Gonzalogontad/ProyectoFinalCESEGG/Hard/ModAdicionales/Mod_Temp_Driver/Mod_Temp_Driver.kicad_pcb

## KiCad design Hard/ModAdicionales/Mod_Temp_Driver/Mod_Temp_Driver.kicad_pcb (2020-06-04)

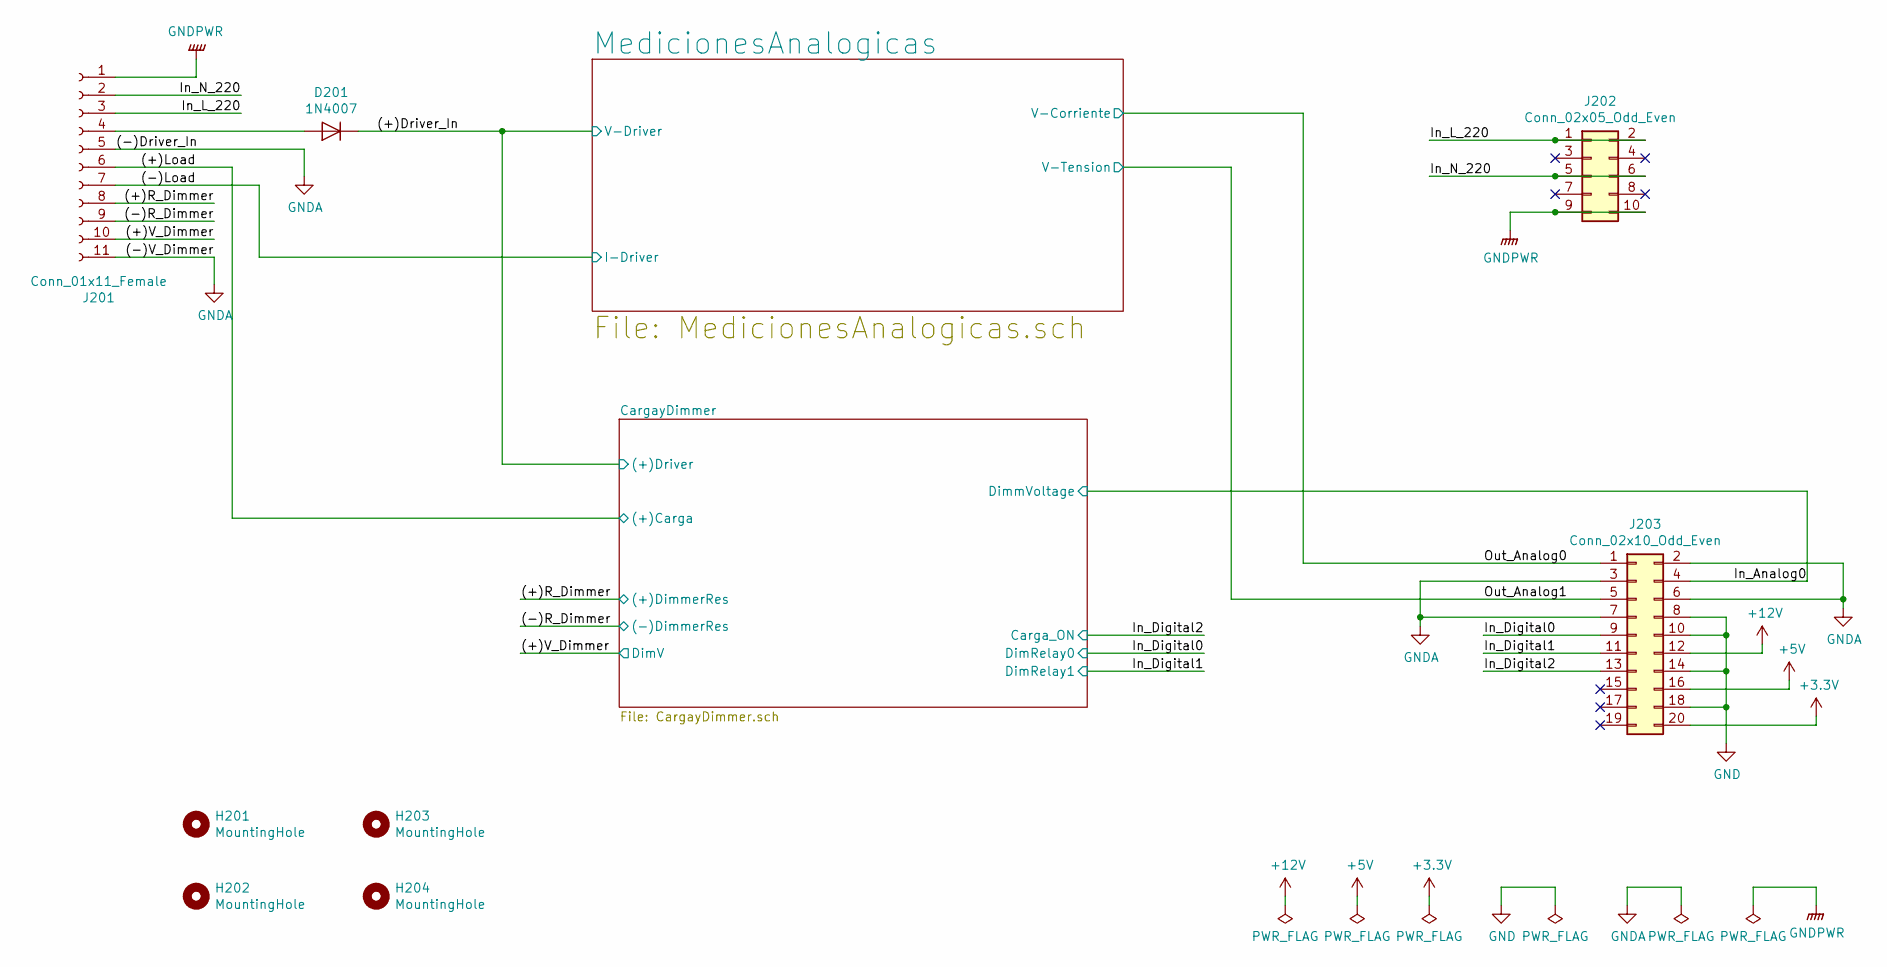
[picture p1: schematic ProbadorDriver.sch, Proyecto Final - Modulos Adicionales]

Parts:
D201: 1N4007; D_DO-41_SOD81_P10.16mm_Horizontal
H201, H202, H203, H204: MountingHole; MountingHole_3.2mm_M3
J201: Conn_01x11_Female; TerminalBlock_bornier-11_P5.00mm
J202: Conn_02x05_Odd_Even; PinHeader_2x05_P2.54mm_Horizontal
J203: Conn_02x10_Odd_Even; PinHeader_2x10_P2.54mm_Horizontal

Connections:
+3V3: J203.20
+5V: J203.16
+12V: J203.12; also elsewhere on the board
/ProbadorDriver/(+)Driver_In: D201.1 (K); also elsewhere on the board
/ProbadorDriver/(+)Load: J201.6; also elsewhere on the board
/ProbadorDriver/(+)R_Dimmer: J201.8; also elsewhere on the board
/ProbadorDriver/(+)V_Dimmer: J201.10; also elsewhere on the board
/ProbadorDriver/(-)Load: J201.7; also elsewhere on the board
/ProbadorDriver/(-)R_Dimmer: J201.9; also elsewhere on the board
/ProbadorDriver/In_Analog0: J203.4; also elsewhere on the board
/ProbadorDriver/In_Digital0: J203.9; also elsewhere on the board
/ProbadorDriver/In_Digital1: J203.11; also elsewhere on the board
/ProbadorDriver/In_Digital2: J203.13; also elsewhere on the board
/ProbadorDriver/In_L_220: J201.3, J202.1, J202.2
/ProbadorDriver/In_N_220: J201.2, J202.5, J202.6
/ProbadorDriver/Out_Analog0: J203.1; also elsewhere on the board
/ProbadorDriver/Out_Analog1: J203.5; also elsewhere on the board
GND: J203.8, J203.10, J203.14, J203.18; also elsewhere on the board
GNDA: J201.5, J201.11, J203.2, J203.3, J203.6, J203.7; also elsewhere on the board
GNDPWR: J201.1, J202.9, J202.10
unnamed: D201.2 (A), J201.4

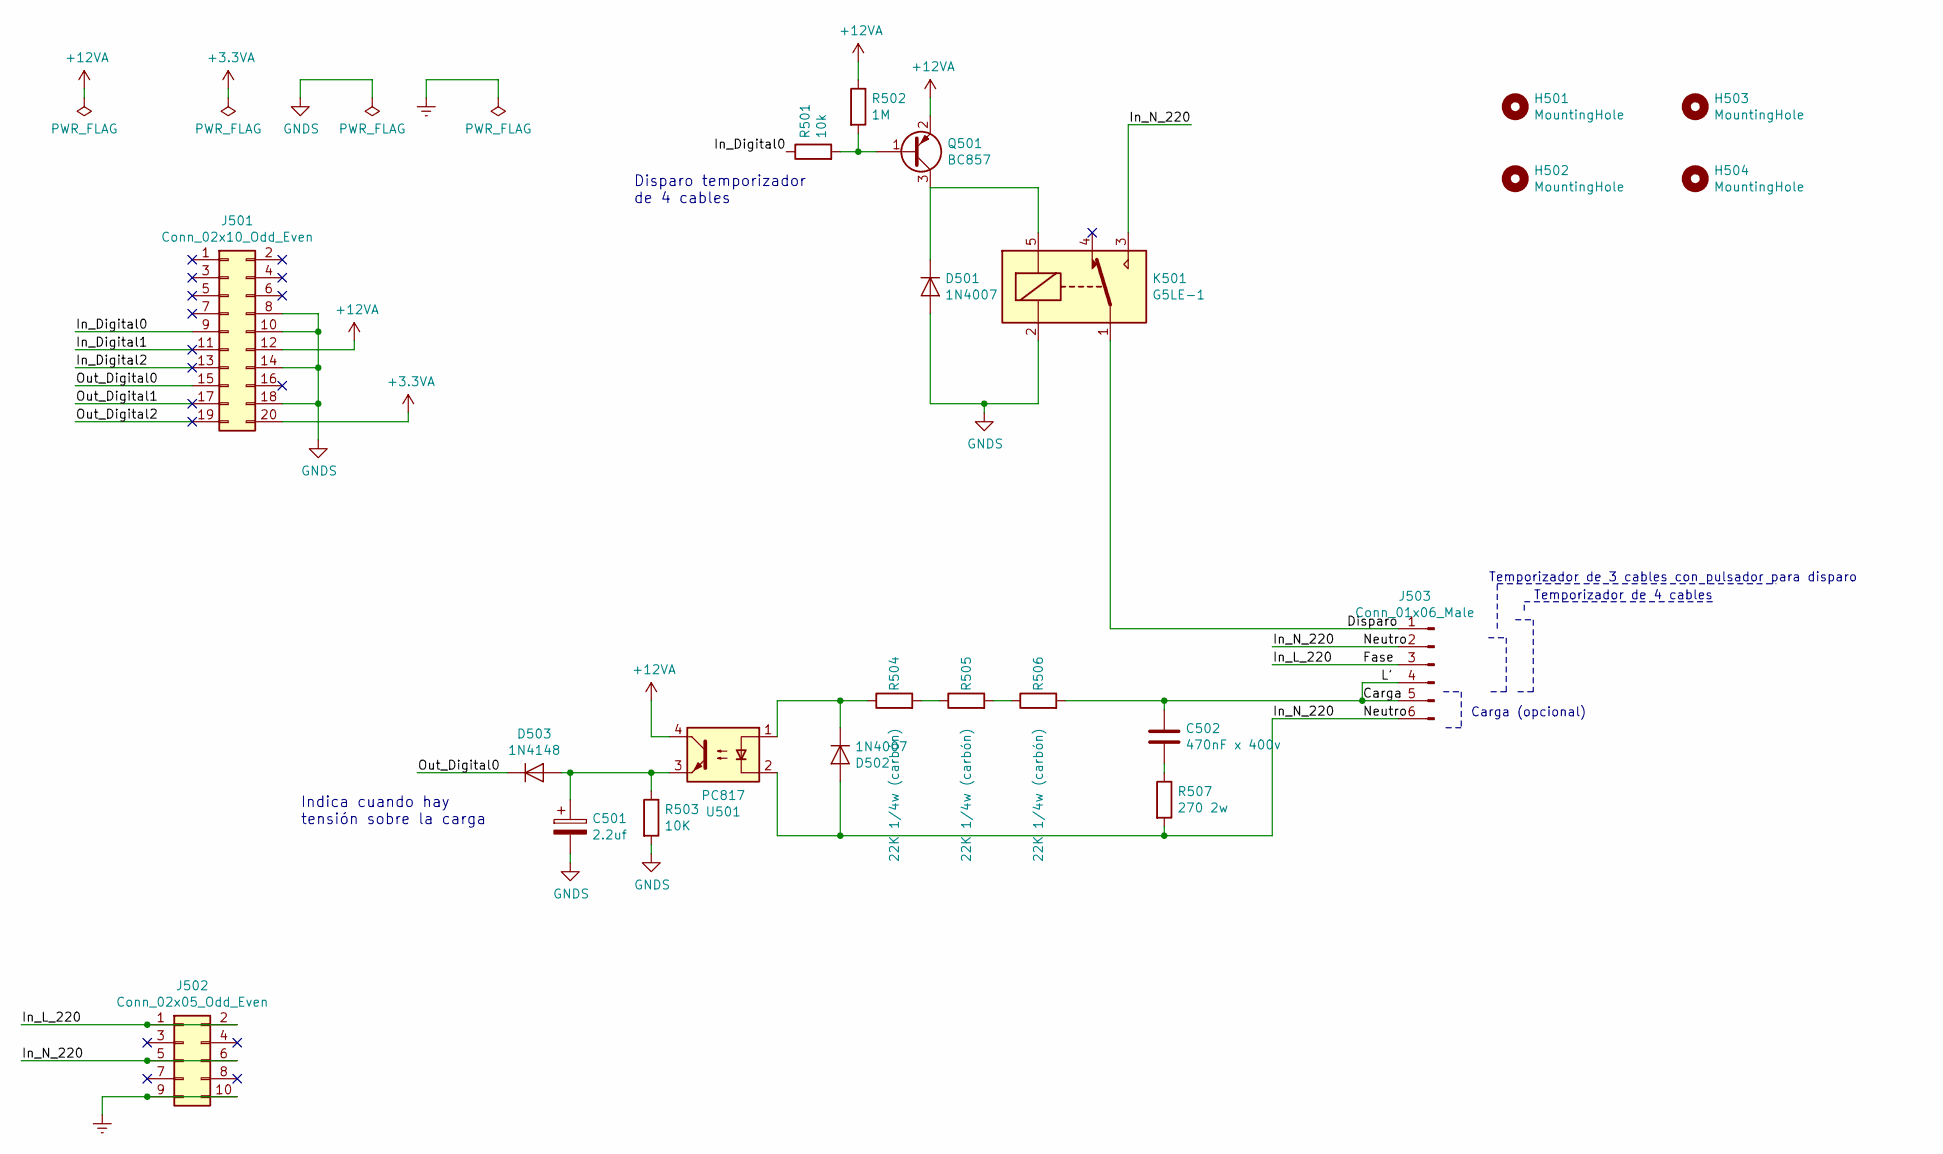
[picture p2: schematic ProbadorTemporizador.sch, Proyecto Final - Modulos Adicionales]

Parts:
C501: 2.2uf; CP_Radial_D5.0mm_P2.00mm
C502: 470nF x 400v; C_Rect_L16.5mm_W8.7mm_P15.00mm_MKT
D501, D502: 1N4007; D_DO-41_SOD81_P10.16mm_Horizontal
D503: 1N4148; D_MiniMELF
H501, H502, H503, H504: MountingHole; MountingHole_3.2mm_M3
J501: Conn_02x10_Odd_Even; PinHeader_2x10_P2.54mm_Horizontal
J502: Conn_02x05_Odd_Even; PinHeader_2x05_P2.54mm_Horizontal
J503: Conn_01x06_Male; TerminalBlock_bornier-6_P5.00mm
K501: G5LE-1; Relay_SPDT_Omron-G5LE-1
Q501: BC857; SOT-23
R501: 10k; R_0805_2012Metric_Pad1.15x1.40mm_HandSolder
R502: 1M; R_0805_2012Metric_Pad1.15x1.40mm_HandSolder
R503: 10K; R_0805_2012Metric_Pad1.15x1.40mm_HandSolder
R504, R505, R506: 22K 1/4w (carbón); R_Axial_DIN0207_L6.3mm_D2.5mm_P7.62mm_Horizontal
R507: 270 2w; R_Axial_DIN0516_L15.5mm_D5.0mm_P20.32mm_Horizontal
U501: PC817; DIP-4_W7.62mm

Connections:
+3.3VA: J501.20
+12VA: J501.12, Q501.2 (E), R502.1, U501.4
/ProbadorTemporizador/Carga: C502.1, J503.4, J503.5, R506.2
/ProbadorTemporizador/Disparo: J503.1, K501.1
/ProbadorTemporizador/Fase: J502.1, J502.2, J503.3
/ProbadorTemporizador/In_Digital0: J501.9, R501.1
/ProbadorTemporizador/In_Digital1: J501.11
/ProbadorTemporizador/In_Digital2: J501.13
/ProbadorTemporizador/In_N_220: D502.2 (A), J502.5, J502.6, J503.2, J503.6, K501.3, R507.2, U501.2
/ProbadorTemporizador/Out_Digital0: D503.1 (K), J501.15
/ProbadorTemporizador/Out_Digital1: J501.17
/ProbadorTemporizador/Out_Digital2: J501.19
Earth: J502.9, J502.10
GNDS: C501.2, D501.2 (A), J501.8, J501.10, J501.14, J501.18, K501.2, R503.2
unnamed: C501.1, D503.2 (A), R503.1, U501.3
unnamed: C502.2, R507.1
unnamed: D501.1 (K), K501.5, Q501.3 (C)
unnamed: D502.1 (K), R504.1, U501.1
unnamed: Q501.1 (B), R501.2, R502.2
unnamed: R504.2, R505.1
unnamed: R505.2, R506.1

Notes on the sheet:
Carga (opcional)
Temporizador de 3 cables con pulsador para disparo
Temporizador de 4 cables
Disparo temporizador de 4 cables
Indica cuando hay tensión sobre la carga

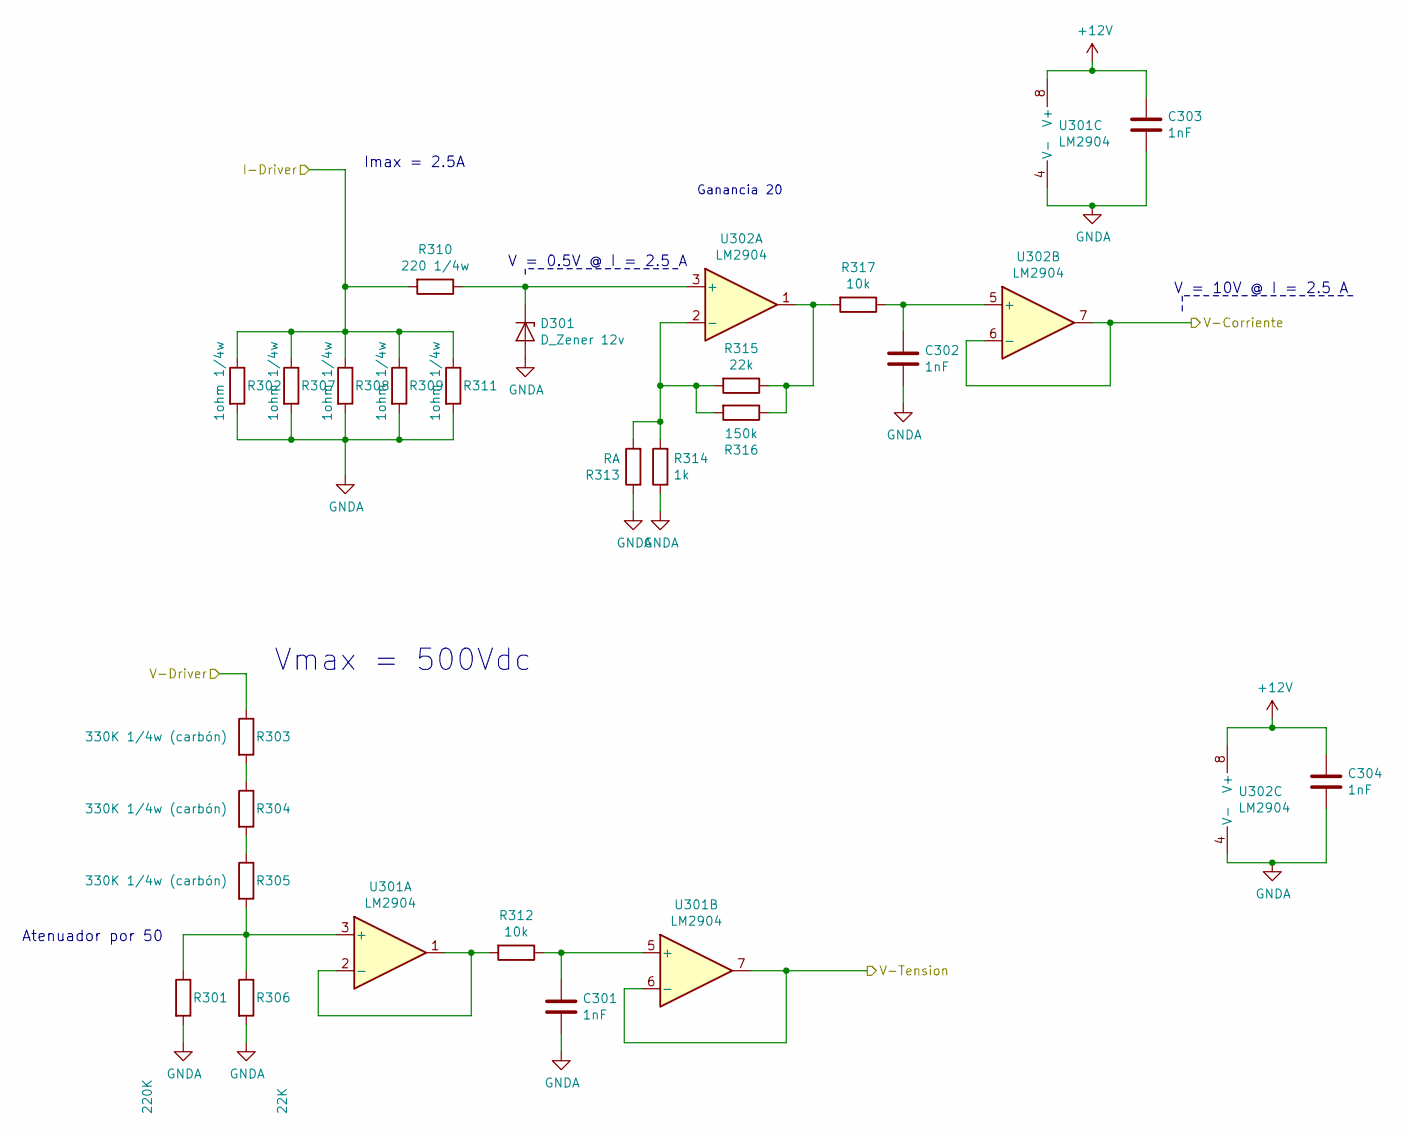
[picture p3: schematic MedicionesAnalogicas.sch, Proyecto Final - Modulos Adicionales]

Parts:
C301, C302, C303, C304: 1nF; C_0805_2012Metric_Pad1.15x1.40mm_HandSolder
D301: D_Zener 12v; D_DO-35_SOD27_P7.62mm_Horizontal
R301: 220K; R_0805_2012Metric_Pad1.15x1.40mm_HandSolder
R302, R307, R308, R309, R311: 1ohm 1/4w; R_Axial_DIN0207_L6.3mm_D2.5mm_P7.62mm_Horizontal
R303, R304, R305: 330K 1/4w (carbón); R_Axial_DIN0207_L6.3mm_D2.5mm_P7.62mm_Horizontal
R306: 22K; R_0805_2012Metric_Pad1.15x1.40mm_HandSolder
R310: 220 1/4w; R_Axial_DIN0207_L6.3mm_D2.5mm_P7.62mm_Horizontal
R312, R317: 10k; R_0805_2012Metric_Pad1.15x1.40mm_HandSolder
R313: RA; R_0805_2012Metric_Pad1.15x1.40mm_HandSolder
R314: 1k; R_0805_2012Metric_Pad1.15x1.40mm_HandSolder
R315: 22k; R_0805_2012Metric_Pad1.15x1.40mm_HandSolder
R316: 150k; R_0805_2012Metric_Pad1.15x1.40mm_HandSolder
U301, U302: LM2904; SO-8_3.9x4.9mm_P1.27mm

Connections:
+12V: C303.1, C304.1, U301.8 (V+), U302.8 (V+); also elsewhere on the board
/ProbadorDriver/(+)Driver_In: R303.1; also elsewhere on the board
/ProbadorDriver/(-)Load: R302.1, R307.1, R308.1, R309.1, R310.2, R311.1; also elsewhere on the board
/ProbadorDriver/Out_Analog0: U302.6 (-), U302.7; also elsewhere on the board
/ProbadorDriver/Out_Analog1: U301.6 (-), U301.7; also elsewhere on the board
GNDA: C301.2, C302.2, C303.2, C304.2, D301.2 (A), R301.2, R302.2, R306.2, R307.2, R308.2, R309.2, R311.2, R313.1, R314.1, U301.4 (V-), U302.4 (V-); also elsewhere on the board
unnamed: C301.1, R312.1, U301.5 (+)
unnamed: C302.1, R317.1, U302.5 (+)
unnamed: D301.1 (K), R310.1, U302.3 (+)
unnamed: R301.1, R305.2, R306.1, U301.3 (+)
unnamed: R303.2, R304.1
unnamed: R304.2, R305.1
unnamed: R312.2, U301.1, U301.2 (-)
unnamed: R313.2, R314.2, R315.2, R316.2, U302.2 (-)
unnamed: R315.1, R316.1, R317.2, U302.1

Notes on the sheet:
Ganancia 20
Vmax = 500Vdc
Atenuador por 50
Imax = 2.5A
V = 0.5V @ I = 2.5 A
V = 10V @ I = 2.5 A

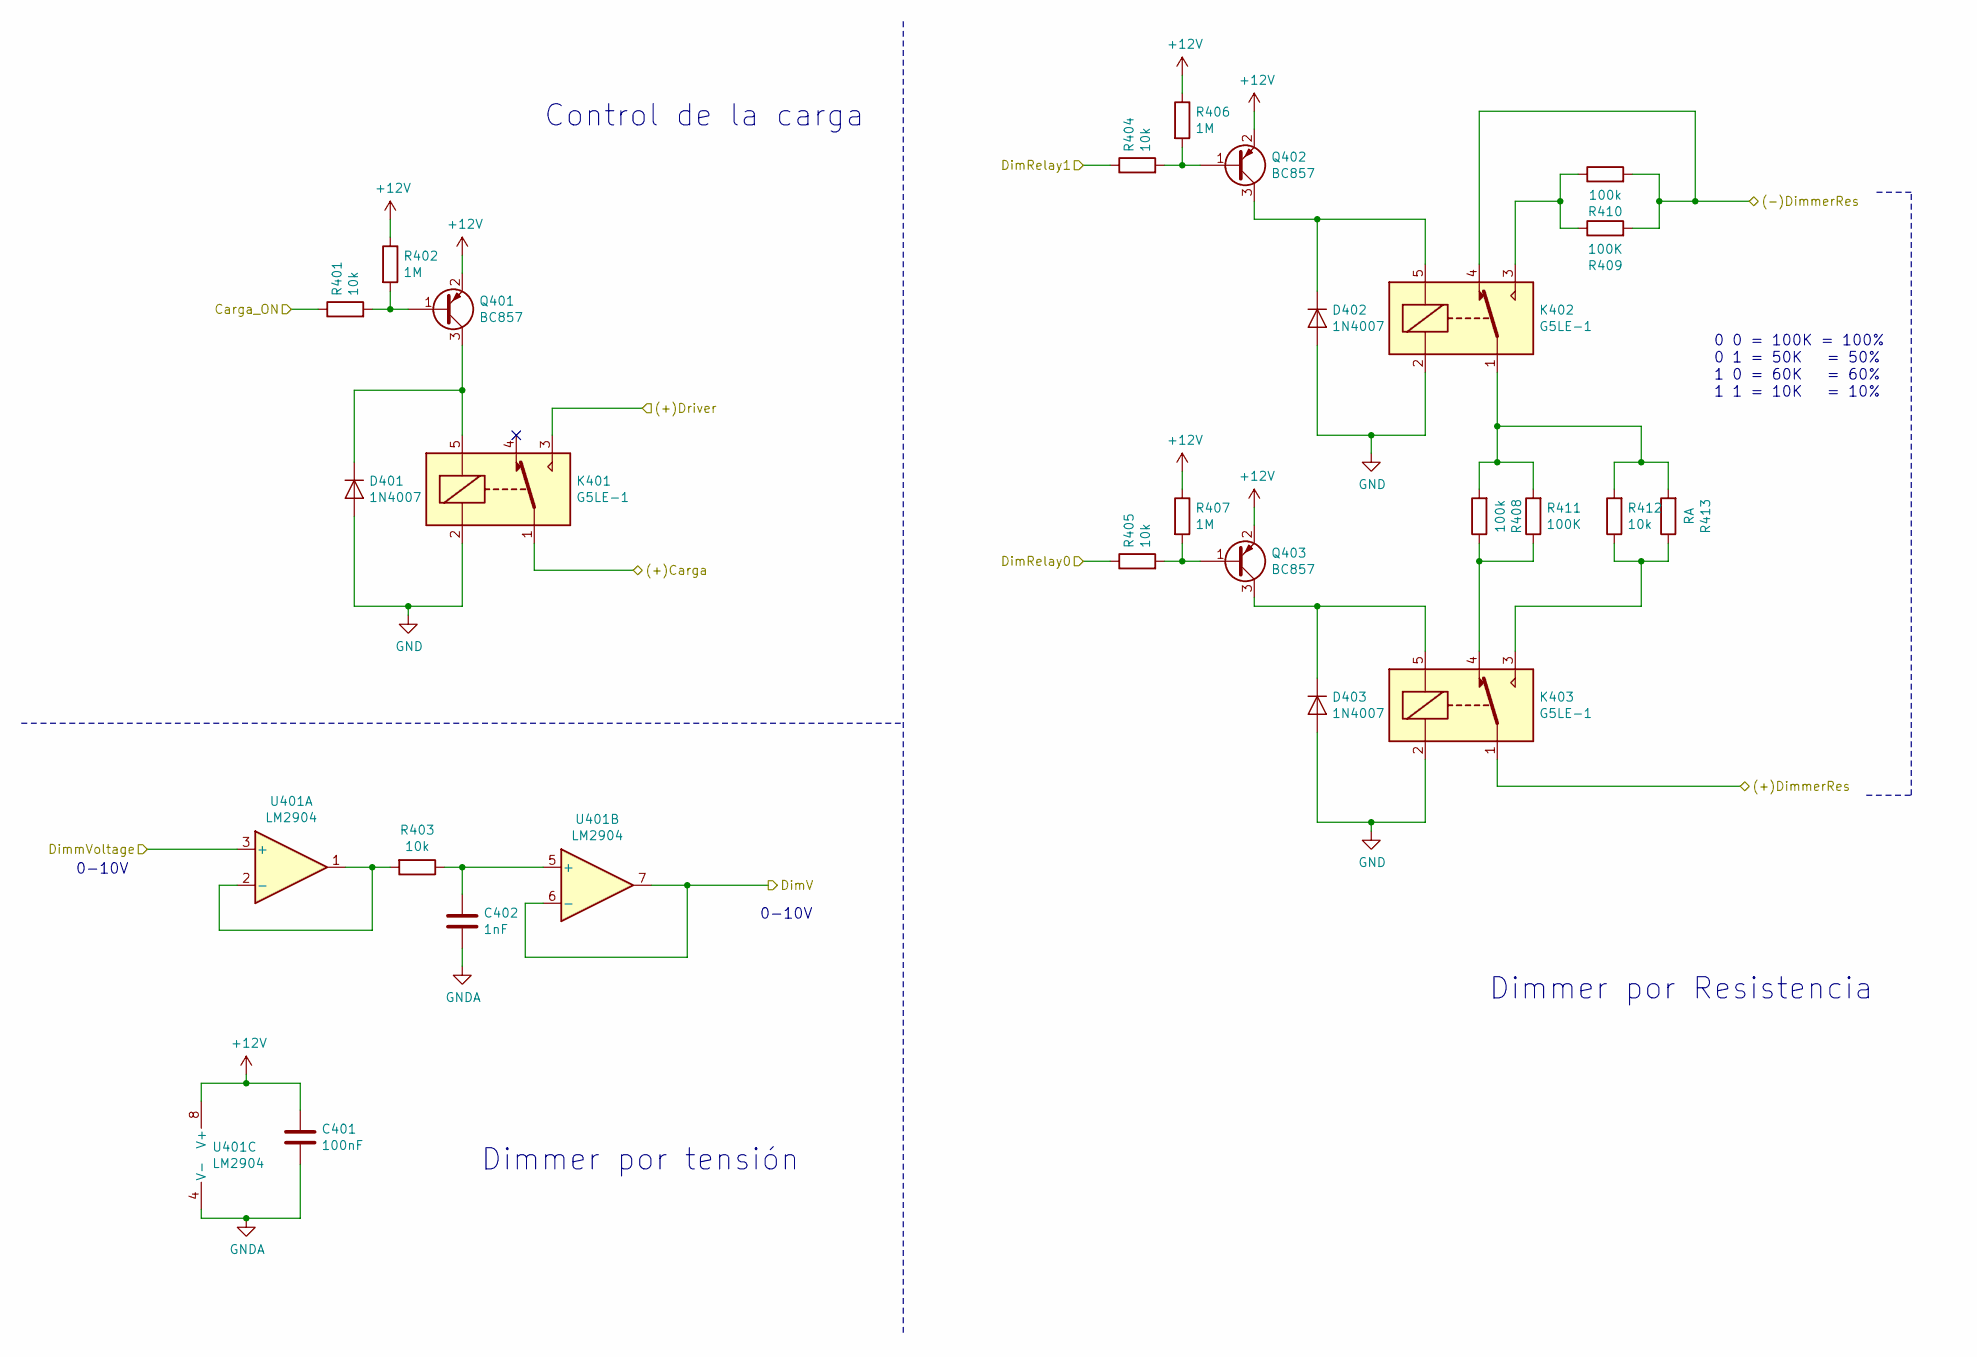
[picture p4: schematic CargayDimmer.sch, Proyecto Final - Modulos Adicionales]

Parts:
C401: 100nF; C_0805_2012Metric_Pad1.15x1.40mm_HandSolder
C402: 1nF; C_0805_2012Metric_Pad1.15x1.40mm_HandSolder
D401, D402, D403: 1N4007; D_DO-41_SOD81_P10.16mm_Horizontal
K401, K402, K403: G5LE-1; Relay_SPDT_Omron-G5LE-1
Q401, Q402, Q403: BC857; SOT-23
R401, R403, R404, R405, R412: 10k; R_0805_2012Metric_Pad1.15x1.40mm_HandSolder
R402, R406, R407: 1M; R_0805_2012Metric_Pad1.15x1.40mm_HandSolder
R408, R410: 100k; R_0805_2012Metric_Pad1.15x1.40mm_HandSolder
R409, R411: 100K; R_0805_2012Metric_Pad1.15x1.40mm_HandSolder
R413: RA; R_0805_2012Metric_Pad1.15x1.40mm_HandSolder
U401: LM2904; SO-8_3.9x4.9mm_P1.27mm

Connections:
+12V: C401.1, Q401.2 (E), Q402.2 (E), Q403.2 (E), R402.1, R406.1, R407.1, U401.8 (V+); also elsewhere on the board
/ProbadorDriver/(+)Driver_In: K401.3; also elsewhere on the board
/ProbadorDriver/(+)Load: K401.1; also elsewhere on the board
/ProbadorDriver/(+)R_Dimmer: K403.1; also elsewhere on the board
/ProbadorDriver/(+)V_Dimmer: U401.6 (-), U401.7; also elsewhere on the board
/ProbadorDriver/(-)R_Dimmer: K402.4, R409.2, R410.2; also elsewhere on the board
/ProbadorDriver/In_Analog0: U401.3 (+); also elsewhere on the board
/ProbadorDriver/In_Digital0: R405.1; also elsewhere on the board
/ProbadorDriver/In_Digital1: R404.1; also elsewhere on the board
/ProbadorDriver/In_Digital2: R401.1; also elsewhere on the board
GND: D401.2 (A), D402.2 (A), D403.2 (A), K401.2, K402.2, K403.2; also elsewhere on the board
GNDA: C401.2, C402.2, U401.4 (V-); also elsewhere on the board
unnamed: C402.1, R403.1, U401.5 (+)
unnamed: D401.1 (K), K401.5, Q401.3 (C)
unnamed: D402.1 (K), K402.5, Q402.3 (C)
unnamed: D403.1 (K), K403.5, Q403.3 (C)
unnamed: K402.1, R408.2, R411.2, R412.2, R413.2
unnamed: K402.3, R409.1, R410.1
unnamed: K403.3, R412.1, R413.1
unnamed: K403.4, R408.1, R411.1
unnamed: Q401.1 (B), R401.2, R402.2
unnamed: Q402.1 (B), R404.2, R406.2
unnamed: Q403.1 (B), R405.2, R407.2
unnamed: R403.2, U401.1, U401.2 (-)

Notes on the sheet:
Control de la carga
Dimmer por tensión
Dimmer por Resistencia
0-10V
0 0 = 100K = 100% 0 1 = 50K = 50% 1 0 = 60K = 60% 1 1 = 10K = 10%

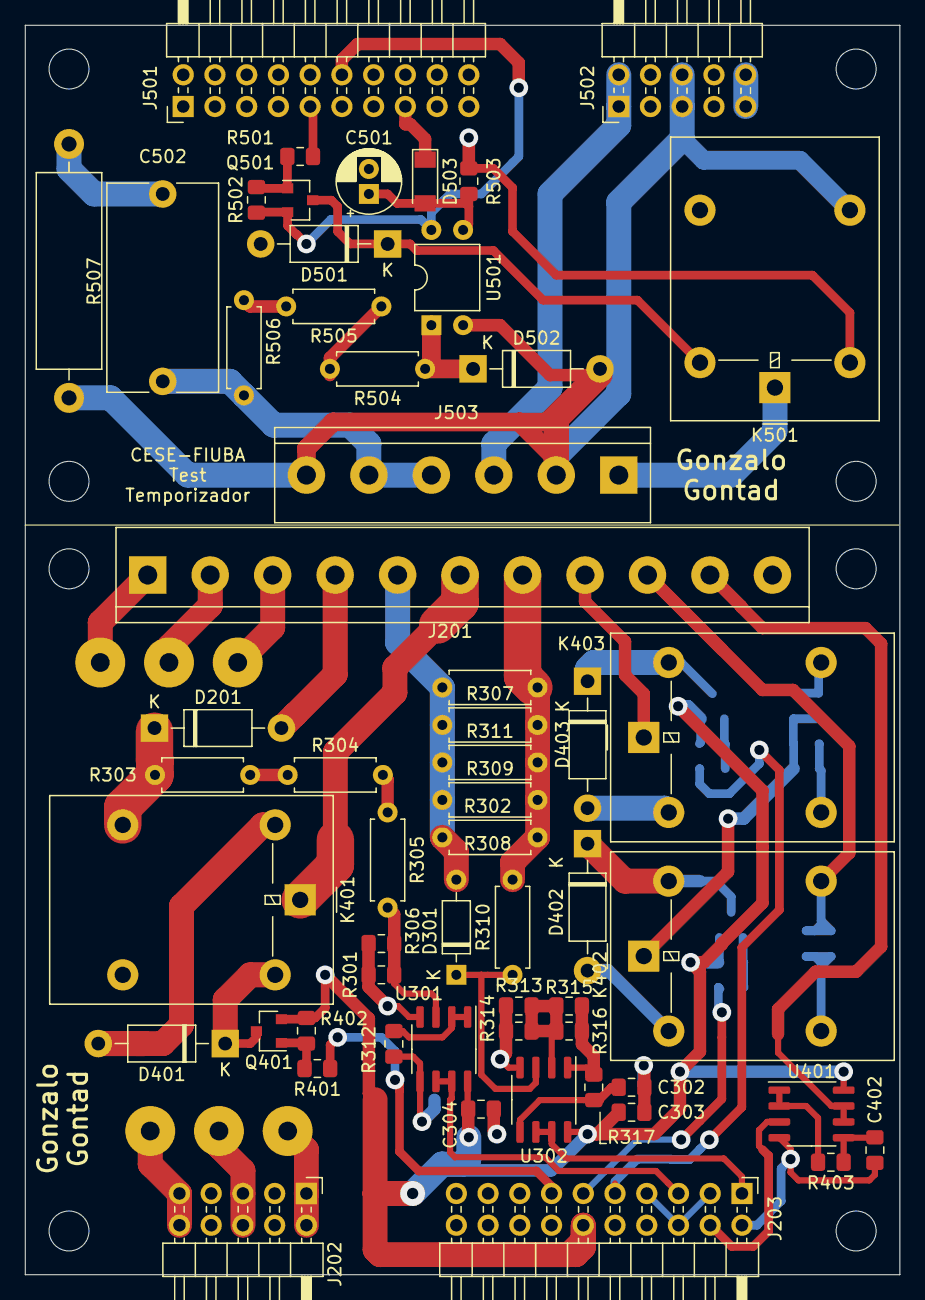
[picture p5: board Mod_Temp_Driver.kicad_pcb from above]

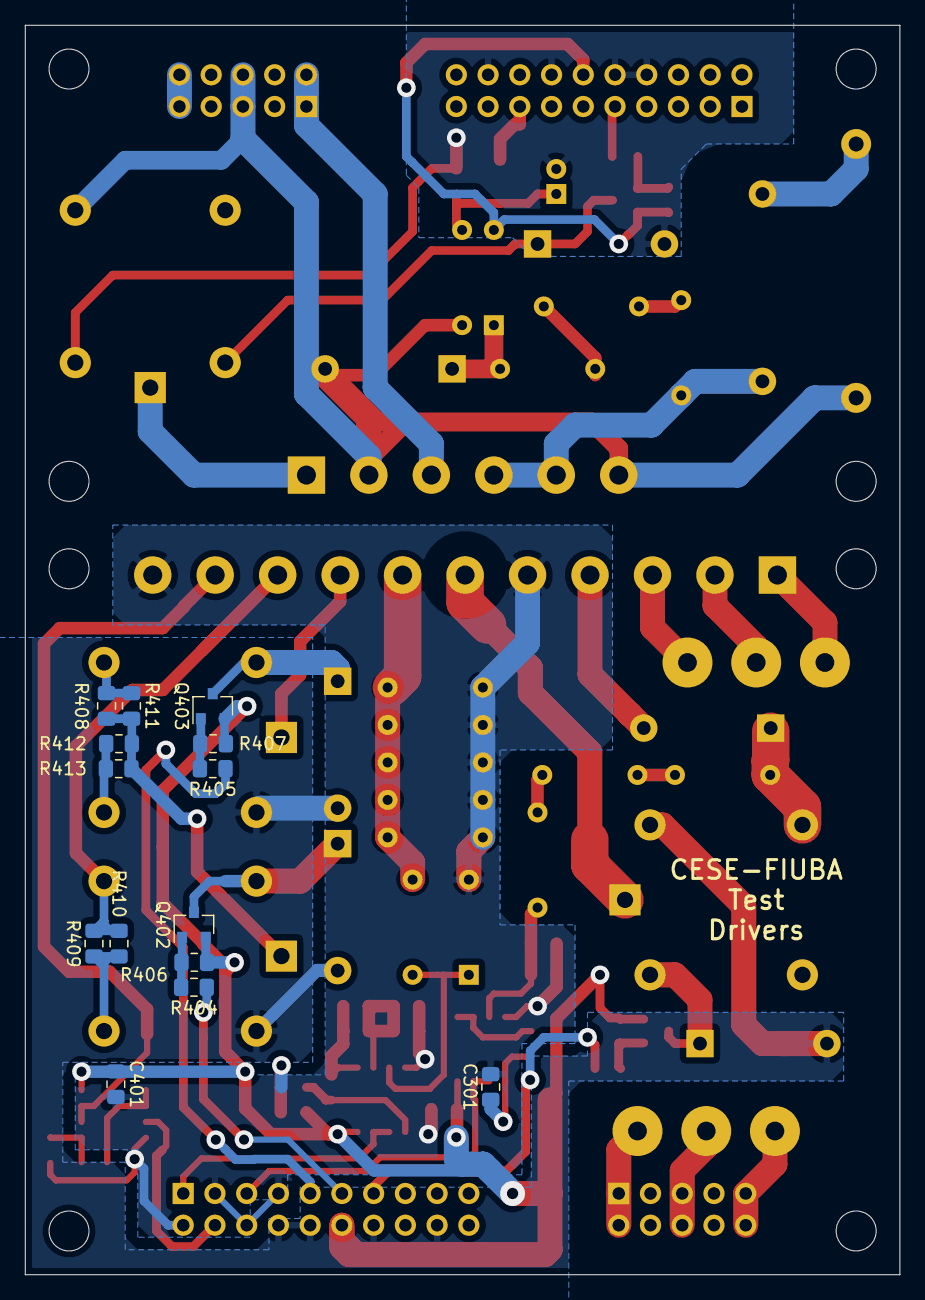
[picture p6: board Mod_Temp_Driver.kicad_pcb from below]

Board: 2 copper layers, 70.0 x 100.0 mm, 79 parts (14 on the bottom side), 56 nets.
