Gonzalogontad/ProyectoFinalCESEGG/Hard/ModPrincipal/ModPrincipal.kicad_pcb

## KiCad design Hard/ModPrincipal/ModPrincipal.kicad_pcb (2020-06-04)

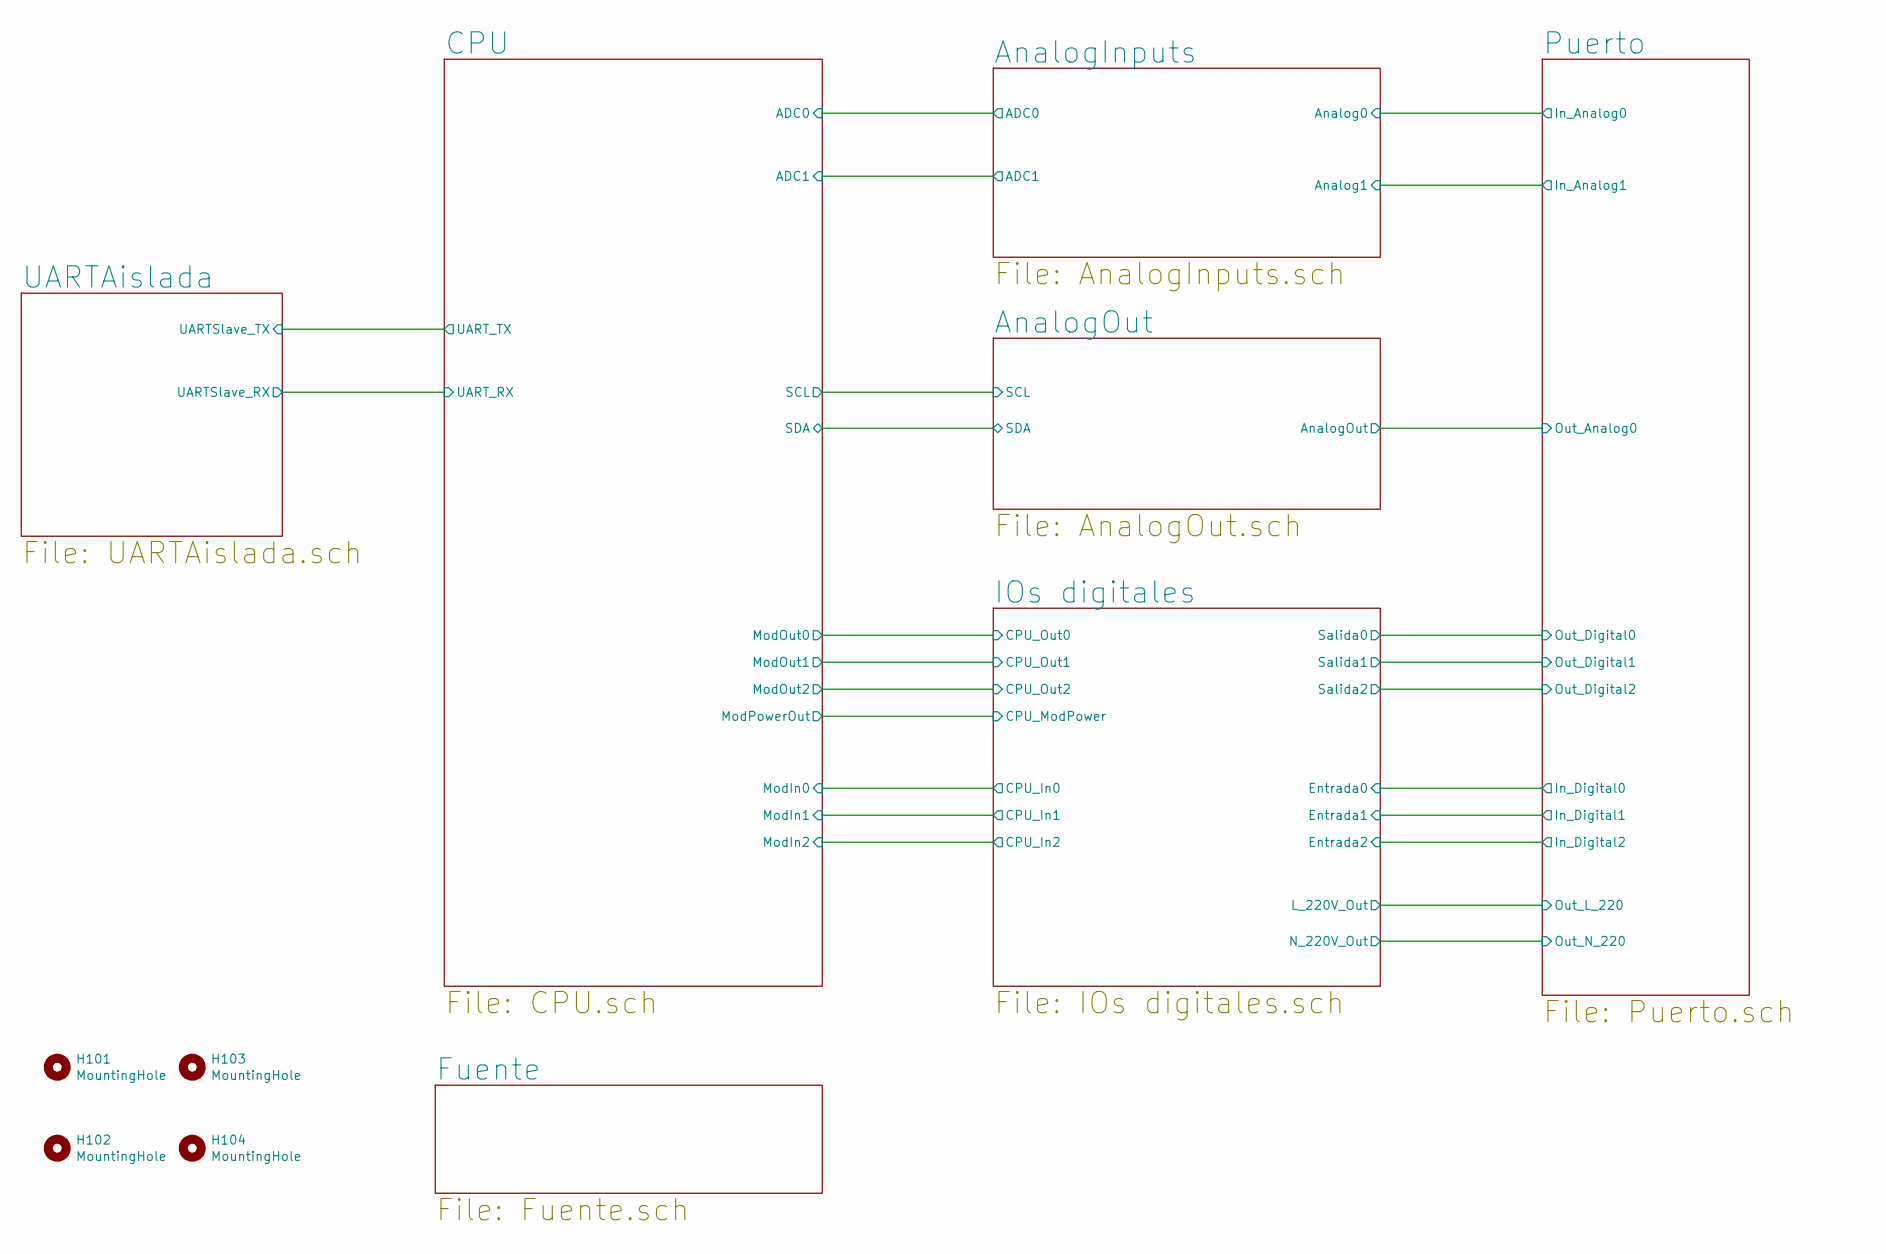
[picture p7: schematic ModPrincipal.sch, Probado - Modulo Principal]

Parts:
H101, H102, H103, H104: MountingHole; MountingHole_3.2mm_M3

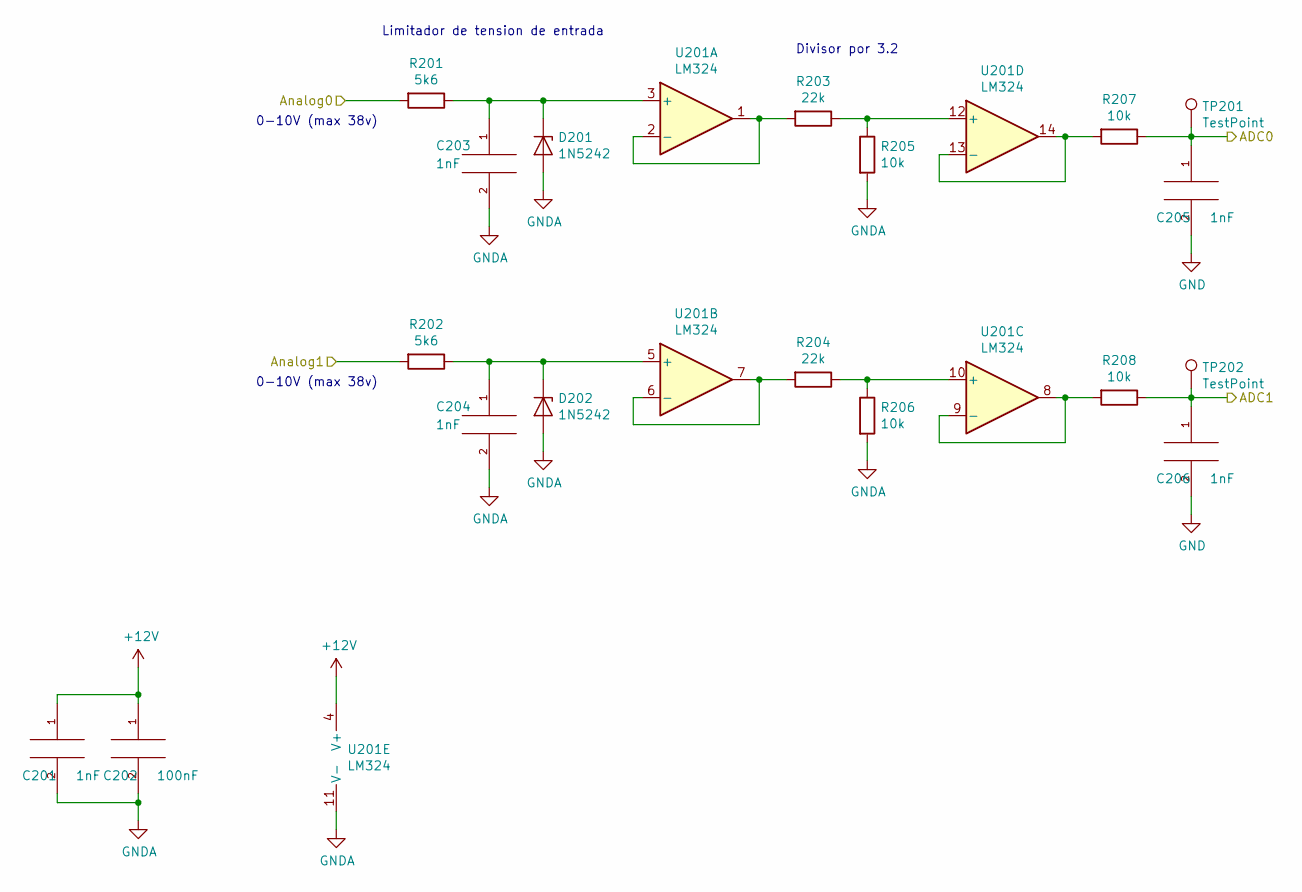
[picture p8: schematic AnalogInputs.sch, Probado - Modulo Principal]

Parts:
C201, C203, C204, C205, C206: 1nF; C_0805_2012Metric_Pad1.15x1.40mm_HandSolder
C202: 100nF; C_0805_2012Metric_Pad1.15x1.40mm_HandSolder
D201, D202: 1N5242; D_DO-35_SOD27_P7.62mm_Horizontal
R201, R202: 5k6; R_0805_2012Metric_Pad1.15x1.40mm_HandSolder
R203, R204: 22k; R_0805_2012Metric_Pad1.15x1.40mm_HandSolder
R205, R206, R207, R208: 10k; R_0805_2012Metric_Pad1.15x1.40mm_HandSolder
TP201, TP202: TestPoint; TestPoint_Pad_D1.5mm
U201: LM324; SOIC-14_3.9x8.7mm_P1.27mm

Connections:
+12V: C201.1, C202.1, U201.4 (V+); also elsewhere on the board
/AnalogInputs/ADC0: C205.1, R207.1, TP201.1; also elsewhere on the board
/AnalogInputs/ADC1: C206.1, R208.1, TP202.1; also elsewhere on the board
/AnalogInputs/Analog0: R201.2; also elsewhere on the board
/AnalogInputs/Analog1: R202.2; also elsewhere on the board
GND: C205.2, C206.2; also elsewhere on the board
GNDA: C201.2, C202.2, C203.2, C204.2, D201.2 (A), D202.2 (A), R205.2, R206.2, U201.11 (V-); also elsewhere on the board
unnamed: C203.1, D201.1 (K), R201.1, U201.3 (+)
unnamed: C204.1, D202.1 (K), R202.1, U201.5 (+)
unnamed: R203.1, R205.1, U201.12 (+)
unnamed: R203.2, U201.1, U201.2 (-)
unnamed: R204.1, R206.1, U201.10 (+)
unnamed: R204.2, U201.6 (-), U201.7
unnamed: R207.2, U201.13 (-), U201.14
unnamed: R208.2, U201.8, U201.9 (-)

Notes on the sheet:
0-10V (max 38v)
Divisor por 3.2
Limitador de tension de entrada

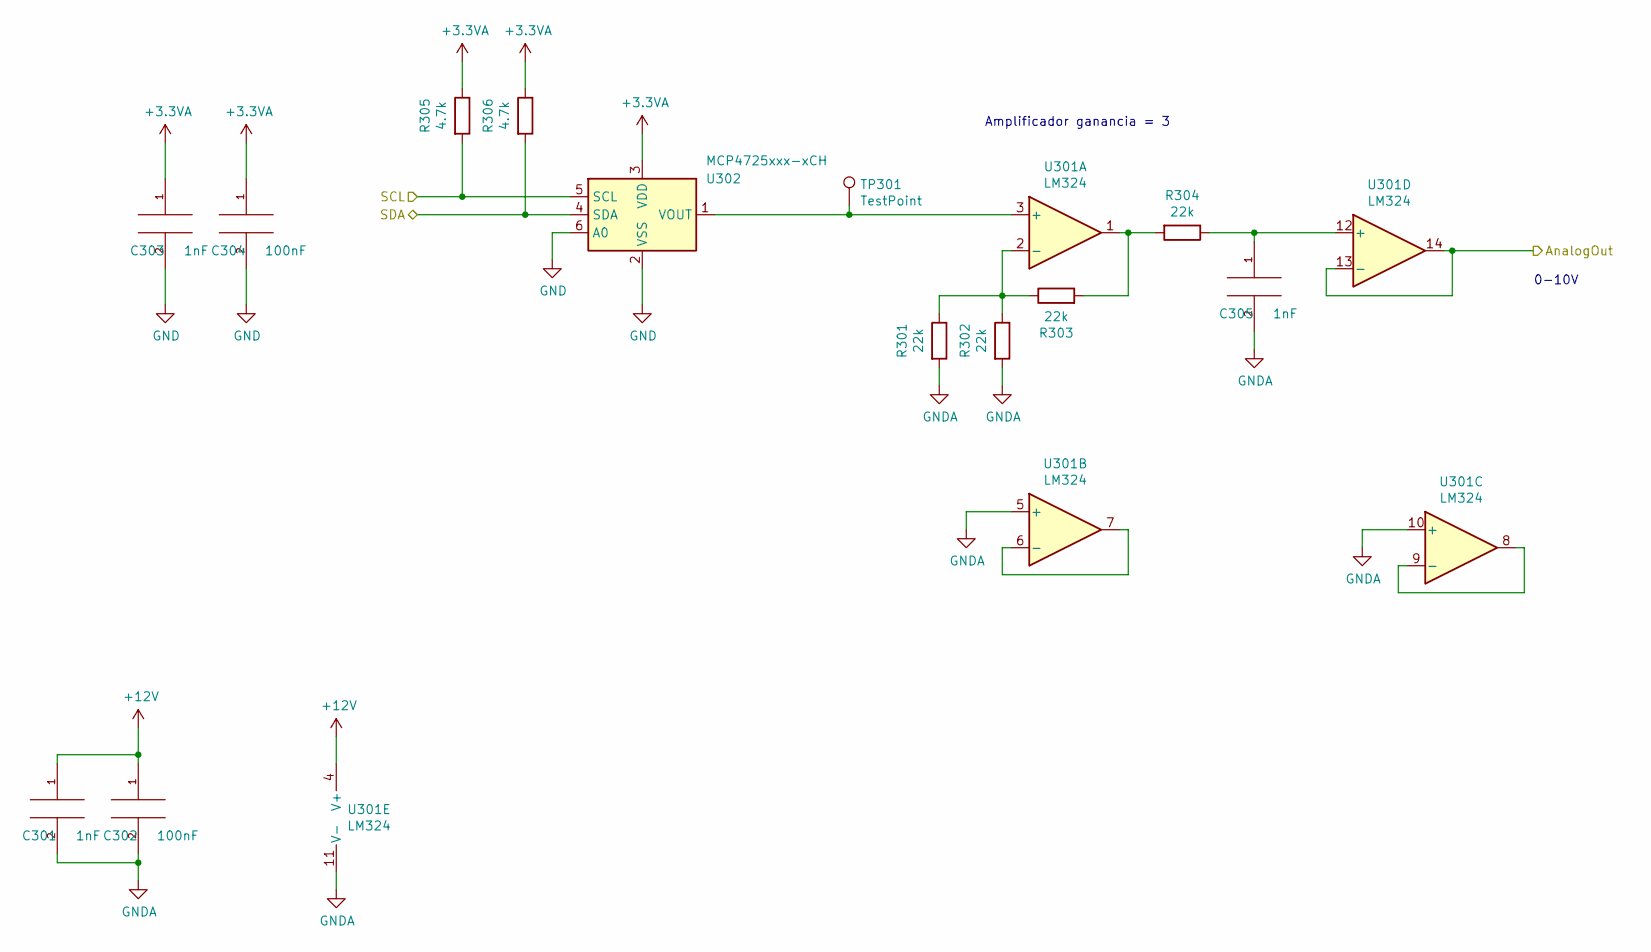
[picture p9: schematic AnalogOut.sch, Probado - Modulo Principal]

Parts:
C301, C303, C305: 1nF; C_0805_2012Metric_Pad1.15x1.40mm_HandSolder
C302, C304: 100nF; C_0805_2012Metric_Pad1.15x1.40mm_HandSolder
R301, R302, R303, R304: 22k; R_0805_2012Metric_Pad1.15x1.40mm_HandSolder
R305, R306: 4.7k; R_0805_2012Metric_Pad1.15x1.40mm_HandSolder
TP301: TestPoint; TestPoint_Pad_D1.5mm
U301: LM324; SOIC-14_3.9x8.7mm_P1.27mm
U302: MCP4725xxx-xCH; SOT-23-6

Connections:
+3.3VA: C303.1, C304.1, R305.1, R306.1, U302.3 (VDD); also elsewhere on the board
+12V: C301.1, C302.1, U301.4 (V+); also elsewhere on the board
/AnalogOut/AnalogOut: U301.13 (-), U301.14; also elsewhere on the board
/AnalogOut/SCL: R305.2, U302.5 (SCL); also elsewhere on the board
/AnalogOut/SDA: R306.2, U302.4 (SDA); also elsewhere on the board
GND: C303.2, C304.2, U302.2 (VSS), U302.6 (A0); also elsewhere on the board
GNDA: C301.2, C302.2, C305.2, R301.2, R302.2, U301.5 (+), U301.10 (+), U301.11 (V-); also elsewhere on the board
unnamed: C305.1, R304.1, U301.12 (+)
unnamed: R301.1, R302.1, R303.1, U301.2 (-)
unnamed: R303.2, R304.2, U301.1
unnamed: TP301.1, U301.3 (+), U302.1 (VOUT)
unnamed: U301.6 (-), U301.7
unnamed: U301.8, U301.9 (-)

Notes on the sheet:
Amplificador ganancia = 3
0-10V
