Gonzalogontad/ProyectoFinalCESEGG/Hard/ModPrincipal/ModPrincipal.kicad_pcb

## KiCad design Hard/ModPrincipal/ModPrincipal.kicad_pcb (continued)

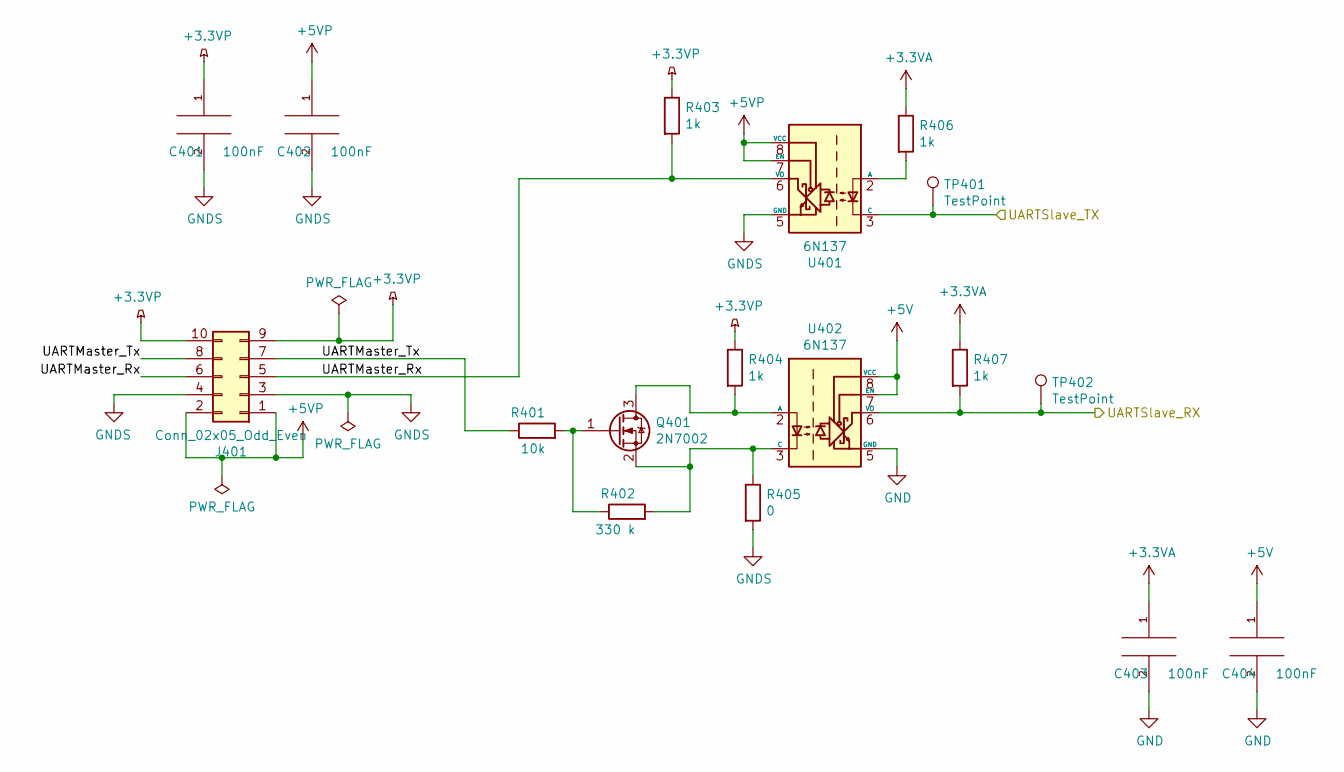
[picture p10: schematic UARTAislada.sch, Probado - Modulo Principal]

Parts:
C401, C402, C403, C404: 100nF; C_0805_2012Metric_Pad1.15x1.40mm_HandSolder
J401: Conn_02x05_Odd_Even; PinHeader_2x05_P2.54mm_Vertical
Q401: 2N7002; SOT-23
R401: 10k; R_0805_2012Metric_Pad1.15x1.40mm_HandSolder
R402: 330 k; R_0805_2012Metric_Pad1.15x1.40mm_HandSolder
R403, R404, R406, R407: 1k; R_0805_2012Metric_Pad1.15x1.40mm_HandSolder
R405: 0; R_0805_2012Metric_Pad1.15x1.40mm_HandSolder
TP401, TP402: TestPoint; TestPoint_Pad_D1.5mm
U401, U402: 6N137; DIP-8_W7.62mm

Connections:
+3.3VA: C403.1, R406.1, R407.1; also elsewhere on the board
+3.3VP: C401.1, J401.9, J401.10, R403.1, R404.1
+5V: C404.1, U402.7 (EN), U402.8 (VCC); also elsewhere on the board
+5VP: C402.1, J401.1, J401.2, U401.7 (EN), U401.8 (VCC)
/UARTAislada/UARTMaster_Rx: J401.5, J401.6, R403.2, U401.6 (VO)
/UARTAislada/UARTMaster_Tx: J401.7, J401.8, R401.1
/UARTAislada/UARTSlave_RX: R407.2, TP402.1, U402.6 (VO); also elsewhere on the board
/UARTAislada/UARTSlave_TX: TP401.1, U401.3 (C); also elsewhere on the board
GND: C403.2, C404.2, U402.5 (GND); also elsewhere on the board
GNDS: C401.2, C402.2, J401.3, J401.4, R405.2, U401.5 (GND)
unnamed: Q401.1 (G), R401.2, R402.1
unnamed: Q401.2 (S), R402.2, R405.1, U402.3 (C)
unnamed: Q401.3 (D), R404.2, U402.2 (A)
unnamed: R406.2, U401.2 (A)

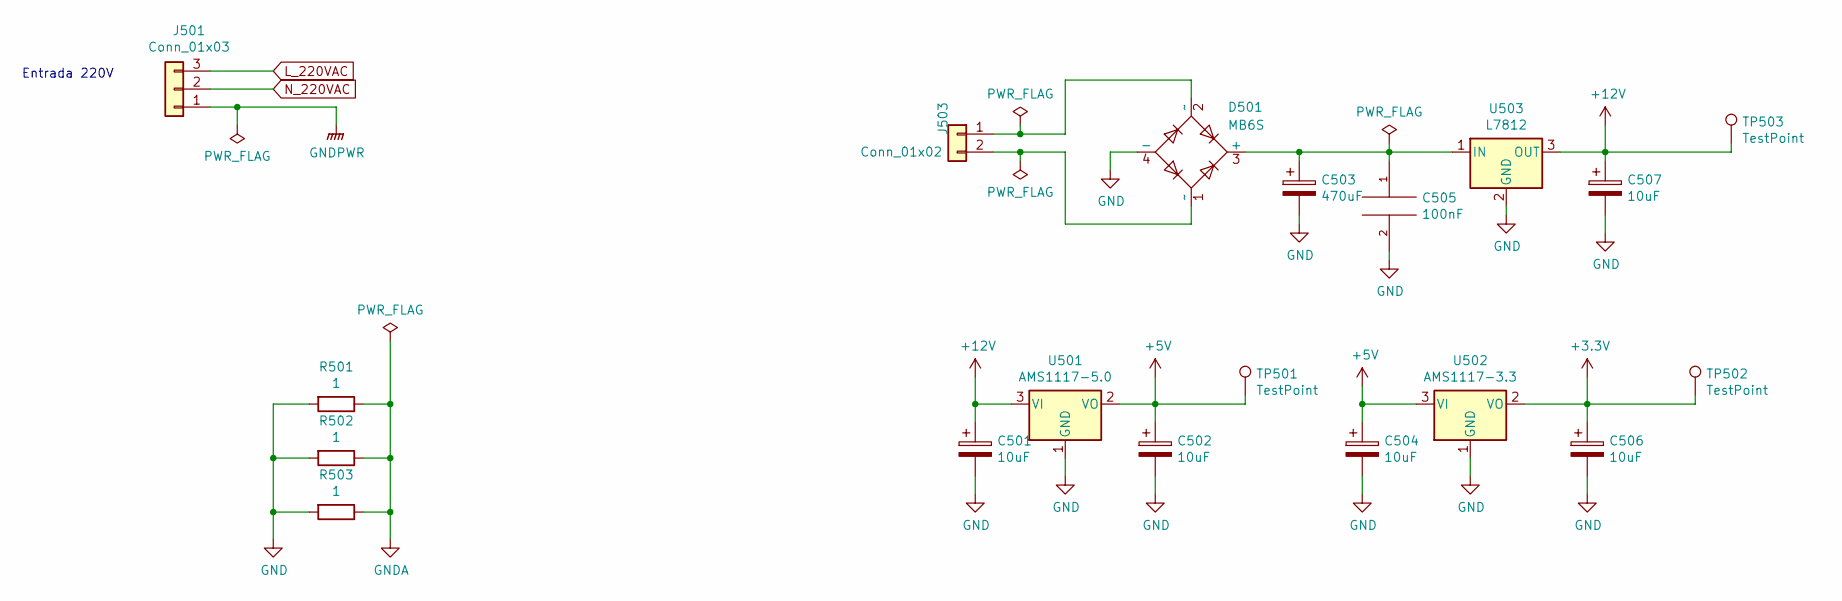
[picture p11: schematic Fuente.sch, Probado - Modulo Principal]

Parts:
C501, C502, C504, C506, C507: 10uF; C_1206_3216Metric_Pad1.42x1.75mm_HandSolder
C503: 470uF; CP_Radial_D8.0mm_P3.50mm
C505: 100nF; C_0805_2012Metric_Pad1.15x1.40mm_HandSolder
D501: MB6S; SO-4_4.4x4.3mm_P2.54mm
J501: Conn_01x03; TerminalBlock_bornier-3_P5.00mm
J503: Conn_01x02; TerminalBlock_bornier-2_P5.00mm
R501, R502, R503: 1; R_0805_2012Metric_Pad1.15x1.40mm_HandSolder
TP501, TP502, TP503: TestPoint; TestPoint_Pad_D1.5mm
U501: AMS1117-5.0; SOT-223-3_TabPin2
U502: AMS1117-3.3; SOT-223-3_TabPin2
U503: L7812; TO-220-3_Vertical

Connections:
+3V3: C506.1, TP502.1, U502.2 (VO); also elsewhere on the board
+5V: C502.1, C504.1, TP501.1, U501.2 (VO), U502.3 (VI); also elsewhere on the board
+12V: C501.1, C507.1, TP503.1, U501.3 (VI), U503.3 (OUT); also elsewhere on the board
GND: C501.2, C502.2, C503.2, C504.2, C505.2, C506.2, C507.2, D501.4 (-), R501.2, R502.2, R503.2, U501.1 (GND), U502.1 (GND), U503.2 (GND); also elsewhere on the board
GNDA: R501.1, R502.1, R503.1; also elsewhere on the board
GNDPWR: J501.1; also elsewhere on the board
L_220VAC: J501.3; also elsewhere on the board
N_220VAC: J501.2; also elsewhere on the board
unnamed: C503.1, C505.1, D501.3 (+), U503.1 (IN)
unnamed: D501.1 (~~), J503.2
unnamed: D501.2 (~~), J503.1

Notes on the sheet:
Entrada 220V

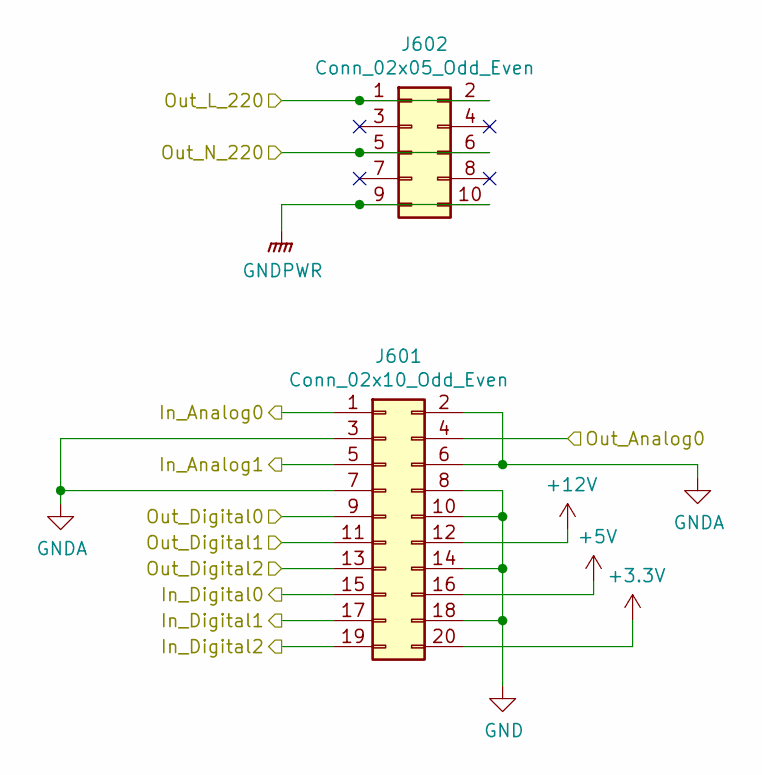
[picture p12: schematic Puerto.sch, Probado - Modulo Principal]

Parts:
J601: Conn_02x10_Odd_Even; PinSocket_2x10_P2.54mm_Horizontal
J602: Conn_02x05_Odd_Even; PinSocket_2x03_Doble_Paso_P2.54mm_Horizontal

Connections:
+3V3: J601.20; also elsewhere on the board
+5V: J601.16; also elsewhere on the board
+12V: J601.12; also elsewhere on the board
/AnalogInputs/Analog0: J601.1; also elsewhere on the board
/AnalogInputs/Analog1: J601.5; also elsewhere on the board
/AnalogOut/AnalogOut: J601.4; also elsewhere on the board
/IOs digitales/Entrada0: J601.15; also elsewhere on the board
/IOs digitales/Entrada1: J601.17; also elsewhere on the board
/IOs digitales/Entrada2: J601.19; also elsewhere on the board
/IOs digitales/L_220V_Out: J602.1, J602.2; also elsewhere on the board
/IOs digitales/N_220V_Out: J602.5, J602.6; also elsewhere on the board
/Puerto/Out_Digital0: J601.9; also elsewhere on the board
/Puerto/Out_Digital1: J601.11; also elsewhere on the board
/Puerto/Out_Digital2: J601.13; also elsewhere on the board
GND: J601.8, J601.10, J601.14, J601.18; also elsewhere on the board
GNDA: J601.2, J601.3, J601.6, J601.7; also elsewhere on the board
GNDPWR: J602.9, J602.10; also elsewhere on the board

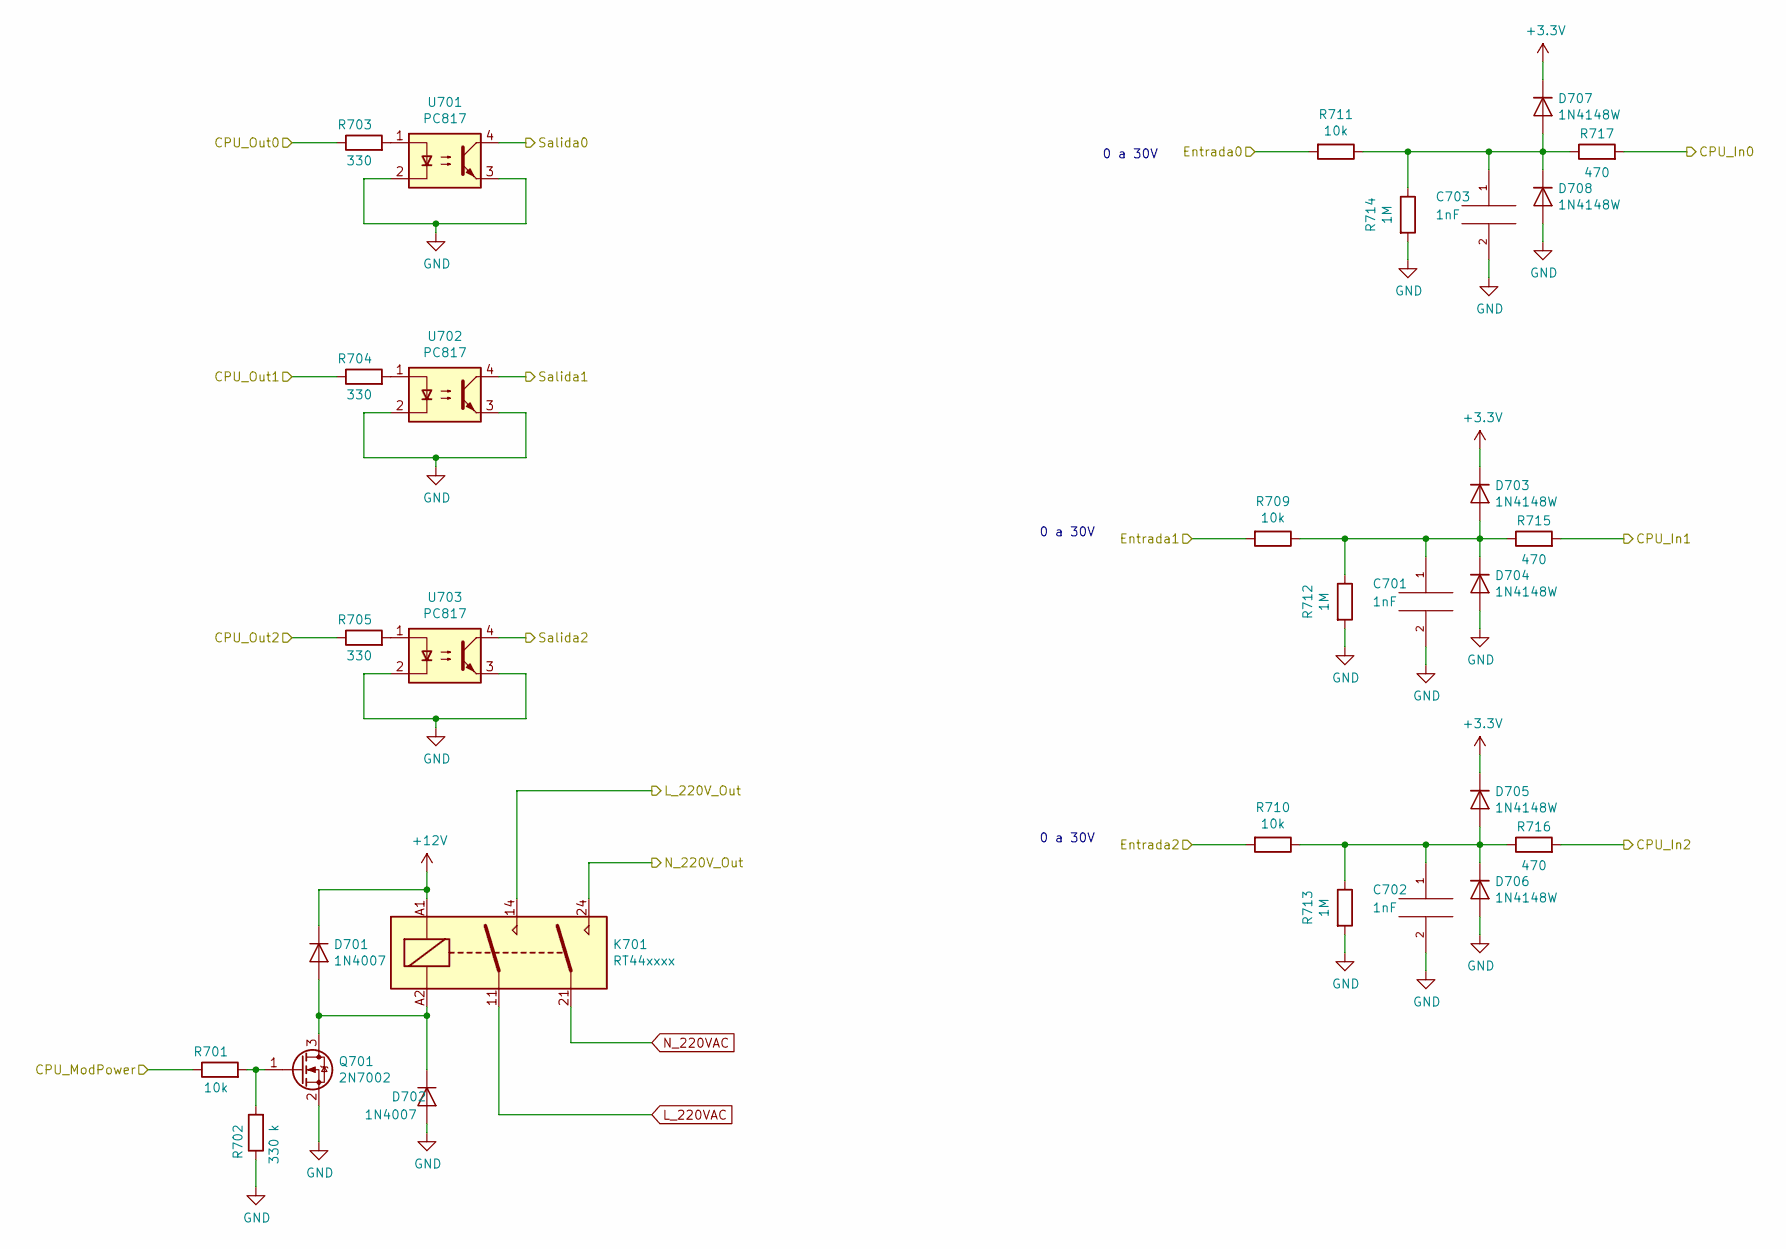
[picture p13: schematic IOs digitales.sch, Probado - Modulo Principal]

Parts:
C701, C702, C703: 1nF; C_0805_2012Metric_Pad1.15x1.40mm_HandSolder
D701, D702: 1N4007; D_DO-41_SOD81_P10.16mm_Horizontal
D703, D704, D705, D706, D707, D708: 1N4148W; D_MiniMELF
K701: RT44xxxx; Relay_DPST_Schrack-RT2-FormA_RM5mm
Q701: 2N7002; SOT-23
R701, R709, R710, R711: 10k; R_0805_2012Metric_Pad1.15x1.40mm_HandSolder
R702: 330 k; R_0805_2012Metric_Pad1.15x1.40mm_HandSolder
R703, R704, R705: 330; R_0805_2012Metric_Pad1.15x1.40mm_HandSolder
R712, R713, R714: 1M; R_0805_2012Metric_Pad1.15x1.40mm_HandSolder
R715, R716, R717: 470; R_0805_2012Metric_Pad1.15x1.40mm_HandSolder
U701, U702, U703: PC817; SO-4_7.6x3.6mm_P2.54mm

Connections:
+3V3: D703.1 (K), D705.1 (K), D707.1 (K); also elsewhere on the board
+12V: D701.1 (K), K701.A1; also elsewhere on the board
/IOs digitales/CPU_In0: R717.2; also elsewhere on the board
/IOs digitales/CPU_In1: R715.2; also elsewhere on the board
/IOs digitales/CPU_In2: R716.2; also elsewhere on the board
/IOs digitales/CPU_ModPower: R701.1; also elsewhere on the board
/IOs digitales/CPU_Out0: R703.1; also elsewhere on the board
/IOs digitales/CPU_Out1: R704.1; also elsewhere on the board
/IOs digitales/CPU_Out2: R705.1; also elsewhere on the board
/IOs digitales/Entrada0: R711.2; also elsewhere on the board
/IOs digitales/Entrada1: R709.2; also elsewhere on the board
/IOs digitales/Entrada2: R710.2; also elsewhere on the board
/IOs digitales/L_220V_Out: K701.14; also elsewhere on the board
/IOs digitales/N_220V_Out: K701.24; also elsewhere on the board
/Puerto/Out_Digital0: U701.4; also elsewhere on the board
/Puerto/Out_Digital1: U702.4; also elsewhere on the board
/Puerto/Out_Digital2: U703.4; also elsewhere on the board
GND: C701.2, C702.2, C703.2, D702.2 (A), D704.2 (A), D706.2 (A), D708.2 (A), Q701.2 (S), R702.1, R712.2, R713.2, R714.2, U701.2, U701.3, U702.2, U702.3, U703.2, U703.3; also elsewhere on the board
L_220VAC: K701.11; also elsewhere on the board
N_220VAC: K701.21; also elsewhere on the board
unnamed: C701.1, D703.2 (A), D704.1 (K), R709.1, R712.1, R715.1
unnamed: C702.1, D705.2 (A), D706.1 (K), R710.1, R713.1, R716.1
unnamed: C703.1, D707.2 (A), D708.1 (K), R711.1, R714.1, R717.1
unnamed: D701.2 (A), D702.1 (K), K701.A2, Q701.3 (D)
unnamed: Q701.1 (G), R701.2, R702.2
unnamed: R703.2, U701.1
unnamed: R704.2, U702.1
unnamed: R705.2, U703.1

Notes on the sheet:
0 a 30V

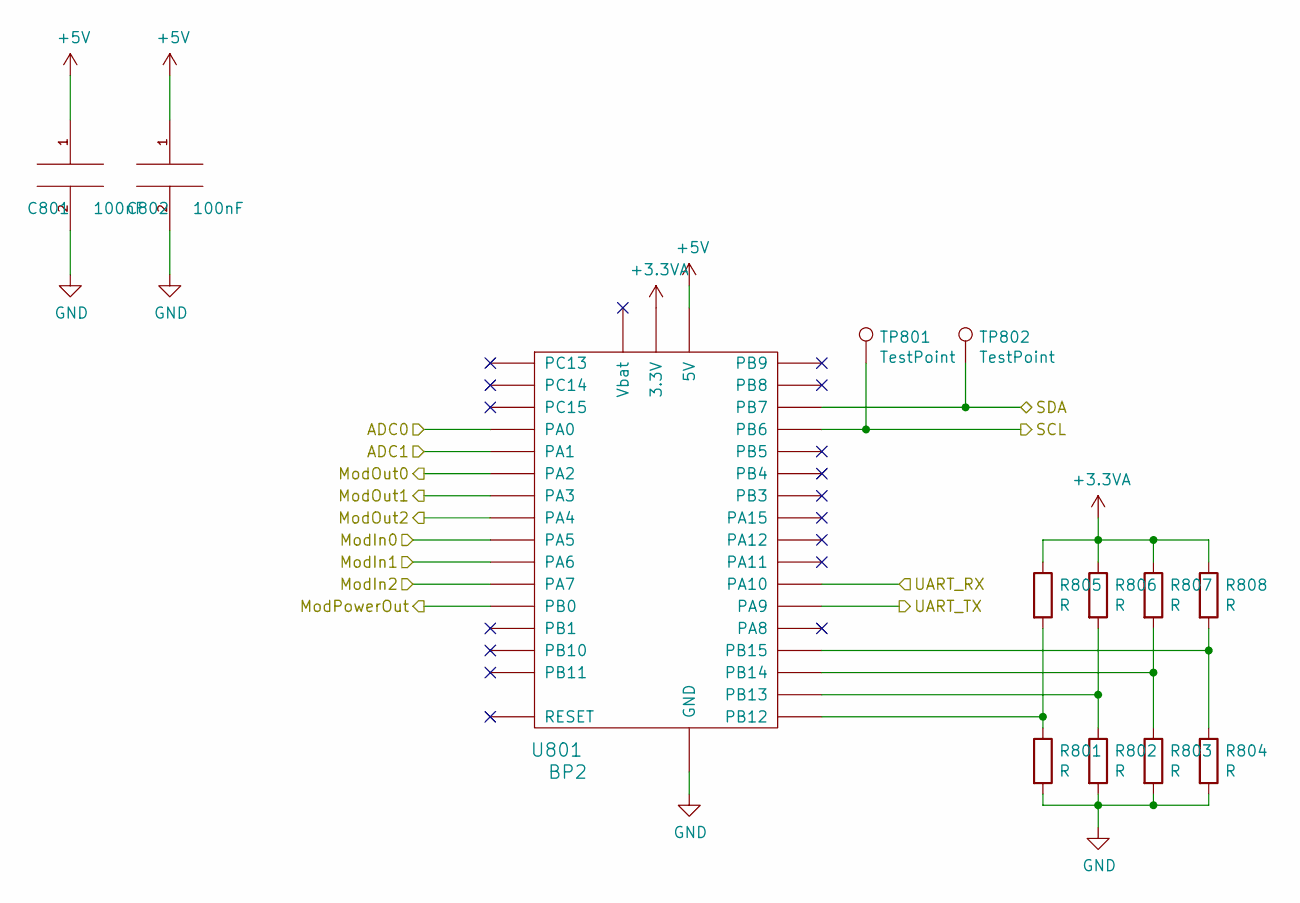
[picture p14: schematic CPU.sch, Probado - Modulo Principal]

Parts:
C801, C802: 100nF; C_0805_2012Metric_Pad1.15x1.40mm_HandSolder
R801, R802, R803, R804, R805, R806, R807, R808: R; R_0805_2012Metric_Pad1.15x1.40mm_HandSolder
TP801, TP802: TestPoint; TestPoint_Pad_D1.5mm
U801: BP2; BLUEPILL2

Connections:
+3.3VA: R805.1, R806.1, R807.1, R808.1, U801.3V3 (3.3V); also elsewhere on the board
+5V: C801.1, C802.1, U801.5V; also elsewhere on the board
/AnalogInputs/ADC0: U801.PA0; also elsewhere on the board
/AnalogInputs/ADC1: U801.PA1; also elsewhere on the board
/AnalogOut/SCL: TP801.1, U801.PB6; also elsewhere on the board
/AnalogOut/SDA: TP802.1, U801.PB7; also elsewhere on the board
/IOs digitales/CPU_In0: U801.PA5; also elsewhere on the board
/IOs digitales/CPU_In1: U801.PA6; also elsewhere on the board
/IOs digitales/CPU_In2: U801.PA7; also elsewhere on the board
/IOs digitales/CPU_ModPower: U801.PB0; also elsewhere on the board
/IOs digitales/CPU_Out0: U801.PA2; also elsewhere on the board
/IOs digitales/CPU_Out1: U801.PA3; also elsewhere on the board
/IOs digitales/CPU_Out2: U801.PA4; also elsewhere on the board
/UARTAislada/UARTSlave_RX: U801.PA10; also elsewhere on the board
/UARTAislada/UARTSlave_TX: U801.PA9; also elsewhere on the board
GND: C801.2, C802.2, R801.2, R802.2, R803.2, R804.2, U801.G (GND); also elsewhere on the board
unnamed: R801.1, R805.2, U801.PB12
unnamed: R802.1, R806.2, U801.PB13
unnamed: R803.1, R807.2, U801.PB14
unnamed: R804.1, R808.2, U801.PB15

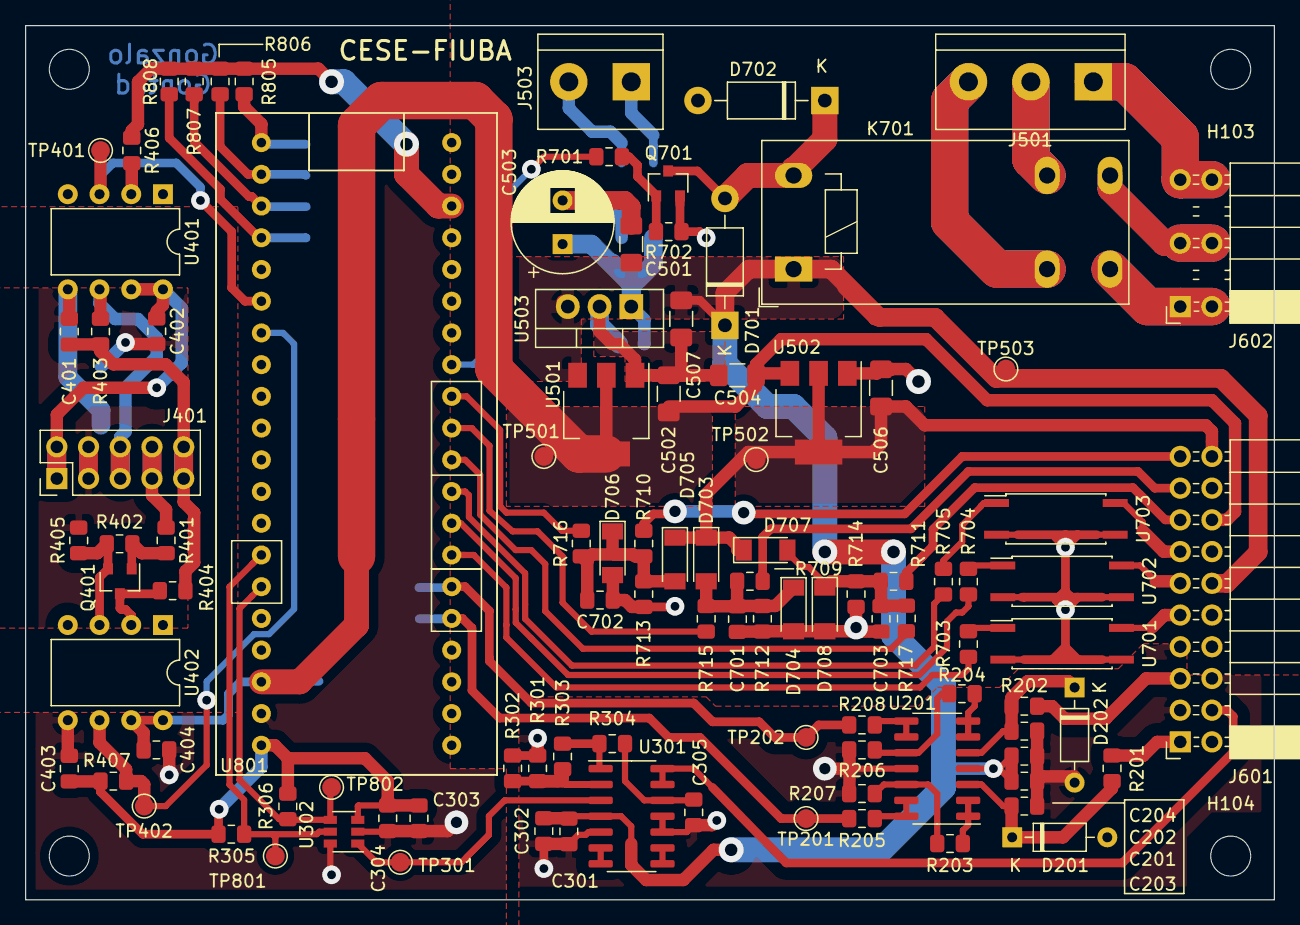
[picture p15: board ModPrincipal.kicad_pcb from above]

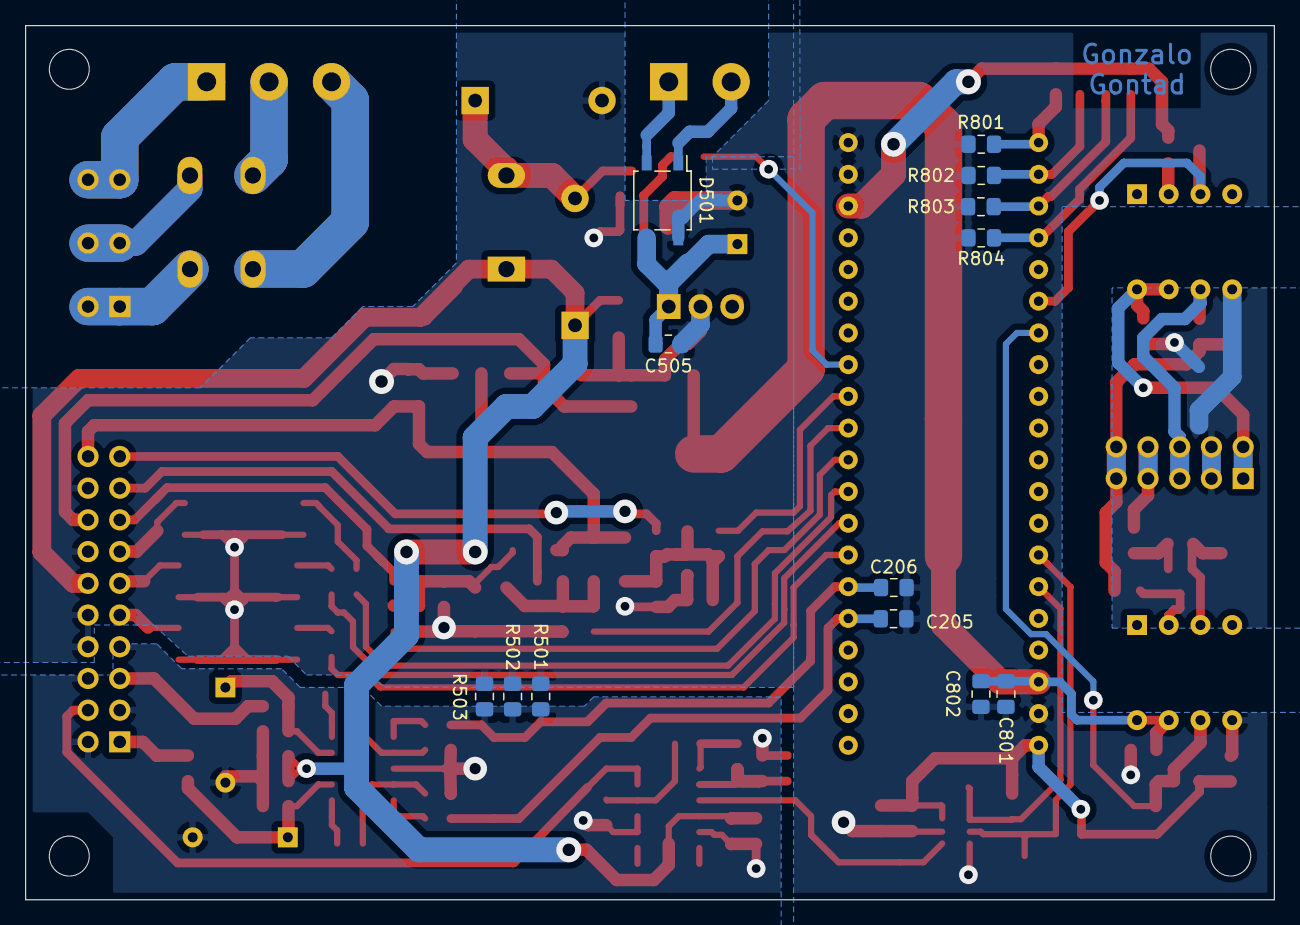
[picture p16: board ModPrincipal.kicad_pcb from below]

Board: 2 copper layers, 100.0 x 70.0 mm, 118 parts (13 on the bottom side), 71 nets.
