Gonzalogontad/ProyectoFinalCESEGG/Soft/Puertos/Core/Src/main.c

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

/* Includes ------------------------------------------------------------------*/
#include "main.h"
#include "adc.h"
#include "i2c.h"
#include "tim.h"
#include "usart.h"
#include "gpio.h"
#include "PuertosData.h"


void SystemClock_Config(void);
/**
  * @brief  The application entry point.
  * @retval int
  */
int main(void)
{
  /* USER CODE BEGIN 1 */
	uint8_t mcpData [2]; //Datos para la interfaz I2C
	uint32_t heartBeatTimeout = 0;
  /* USER CODE END 1 */

  /* MCU Configuration--------------------------------------------------------*/

  /* Reset of all peripherals, Initializes the Flash interface and the Systick. */
  HAL_Init();

  /* Configure the system clock */
  SystemClock_Config();

  /* Initialize all configured peripherals */
  MX_GPIO_Init();
  MX_ADC1_Init();
  MX_ADC2_Init();
  MX_I2C1_Init();
  MX_TIM3_Init();
  MX_USART1_UART_Init();
  /* USER CODE BEGIN 2 */

  //Leo el address del modulo
  if (HAL_GPIO_ReadPin(GPIOB,GPIO_PIN_12)) //
	moduleAddr = moduleAddr | 0x00000001;
  else
	moduleAddr = moduleAddr & 0xFFFFFFFE;

  if (HAL_GPIO_ReadPin(GPIOB,GPIO_PIN_13))
	moduleAddr = moduleAddr | 0x00000002;
  else
	moduleAddr = moduleAddr & 0xFFFFFFFD;

  if (HAL_GPIO_ReadPin(GPIOB,GPIO_PIN_14))
	moduleAddr = moduleAddr | 0x00000004;
  else
	moduleAddr = moduleAddr & 0xFFFFFFFB;

  heartBeatTimeout= HAL_GetTick() + HEART_BEAT_PERIOD;

  HAL_ADC_Start(&hadc1); // start the adc1
  HAL_ADC_Start(&hadc2); // start the adc2

  HAL_TIM_Base_Start_IT(&htim3);

  //Disparo la recepcion por interrupcion de la UART
  	if(HAL_UART_Receive_IT(&huart1, (uint8_t*) &bufferUARTin[receiveIndex], 1) != HAL_OK)
  	  {
  	    Error_Handler();
  	  }
  /* USER CODE END 2 */

  /* Infinite loop */
  /* USER CODE BEGIN WHILE */
  while (1)
  {
  //En un loop infinito si hay datos para el DAC y las salidas digitales las actualizo
	  if (dataFlag == 1)
	  {
		mcpData [0] = DACData[0];	//Tomo los datos a enviar al dac
		mcpData [1] = DACData[1];
		dataFlag = 0;
		HAL_I2C_Master_Transmit_IT(&hi2c1, mcpAddress, mcpData, (uint16_t) 2); //Los envio al DAC

		//Actualizo el estado de las salidas digitales
		if (outData & 0x01)
			HAL_GPIO_WritePin(GPIOA,GPIO_PIN_2,GPIO_PIN_SET);
		else
			HAL_GPIO_WritePin(GPIOA,GPIO_PIN_2,GPIO_PIN_RESET);
		if (outData & 0x02)
			HAL_GPIO_WritePin(GPIOA,GPIO_PIN_3,GPIO_PIN_SET);
		else
			HAL_GPIO_WritePin(GPIOA,GPIO_PIN_3,GPIO_PIN_RESET);
		if (outData & 0x04)
			HAL_GPIO_WritePin(GPIOA,GPIO_PIN_4,GPIO_PIN_SET);
		else
			HAL_GPIO_WritePin(GPIOA,GPIO_PIN_4,GPIO_PIN_RESET);
		if (outData & 0x08)
			HAL_GPIO_WritePin(GPIOB,GPIO_PIN_0,GPIO_PIN_SET);
		else
			HAL_GPIO_WritePin(GPIOB,GPIO_PIN_0,GPIO_PIN_RESET);
	  }


	  if (HAL_GetTick()>=heartBeatTimeout)	//Cada un segundo hago destella el LED de la placa para indicar que esta vivo y actualizo el addres del puerto.
		  {
		  heartBeatTimeout = heartBeatTimeout+HEART_BEAT_PERIOD;

		  HAL_GPIO_TogglePin(GPIOC,GPIO_PIN_13); //Heartbeat

		  //Lectura de entradas digitales
		  if (HAL_GPIO_ReadPin(GPIOB,GPIO_PIN_12)) //
			moduleAddr = moduleAddr | 0x00000001; //Si pasaro 10 bits en 1 pongo en 1 el primer bit
		  else
			moduleAddr = moduleAddr & 0xFFFFFFFE;	//Si pasaro 10 bits en 0 pongo en 0 el primer bit

		  if (HAL_GPIO_ReadPin(GPIOB,GPIO_PIN_13)) //
			moduleAddr = moduleAddr | 0x00000002; //Si pasaro 10 bits en 1 pongo en 1 el segundo bit
		  else
			moduleAddr = moduleAddr & 0xFFFFFFFD; //Si pasaro 10 bits en 0 pongo en 0 el segundo bit

		  if (HAL_GPIO_ReadPin(GPIOB,GPIO_PIN_14)) //
			moduleAddr = moduleAddr | 0x00000004; //Si pasaro 10 bits en 1 pongo en 1 el tercer bit
		  else
			moduleAddr = moduleAddr & 0xFFFFFFFB; //Si pasaro 10 bits en 0 pongo en 0 el tercer bit
		  }

	  /* USER CODE BEGIN 3 */
  }
  /* USER CODE END 3 */
}

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
