Gonzalogontad/ProyectoFinalCESEGG/Soft/Puertos/Core/Inc/main.h

#define ModuleHeartBeat_Pin GPIO_PIN_13
#define ModuleHeartBeat_GPIO_Port GPIOC
#define ModuleOut0_Pin GPIO_PIN_2
#define ModuleOut0_GPIO_Port GPIOA
#define ModuleOut1_Pin GPIO_PIN_3
#define ModuleOut1_GPIO_Port GPIOA
#define ModuleOut2_Pin GPIO_PIN_4
#define ModuleOut2_GPIO_Port GPIOA
#define ModuleIn0_Pin GPIO_PIN_5
#define ModuleIn0_GPIO_Port GPIOA
#define ModuleIn1_Pin GPIO_PIN_6
#define ModuleIn1_GPIO_Port GPIOA
#define ModuleIn2_Pin GPIO_PIN_7
#define ModuleIn2_GPIO_Port GPIOA
#define ModuelAddr0_Pin GPIO_PIN_12
#define ModuelAddr0_GPIO_Port GPIOB
#define ModuelAddr1_Pin GPIO_PIN_13
#define ModuelAddr1_GPIO_Port GPIOB
#define ModuelAddr2_Pin GPIO_PIN_14
#define ModuelAddr2_GPIO_Port GPIOB
#define ModuelAddr3_Pin GPIO_PIN_15
#define ModuelAddr3_GPIO_Port GPIOB
#define DAC_SCL_Pin GPIO_PIN_6
#define DAC_SCL_GPIO_Port GPIOB
#define DAC_SDA_Pin GPIO_PIN_7
#define DAC_SDA_GPIO_Port GPIOB
