Gonzalogontad/ProyectoFinalCESEGG/Soft/modPrincipalCIAA/src/interpreter.c

/*
 * interpreter.c
 *
 *  Created on: 24 jun. 2020
 *      Author: root
 */

#include "interpreter.h"
#include "portsDriver.h"
#include "string.h"
#include "pruebas.h"
#include "webPage.h"
#include "DataMemory.h"

char *panels [TESTS_QTY];
uint32_t *params;

//Funcion de inicializacion de la tarea del interprete de comandos

bool_t interpreterInit()
{
	//Pongo en el vector de paneles los strngs que contienen el codigo HTML 
	//de los paneles correspondientes a las pruebas
	panels [0] = panel0; 
	panels [1] = panel1;
	panels [2] = panel2;

	//Creo la cola del interprete por donde le llegan los botones presionados en la interfaz de usuario y los datos(parametros)
	commandsQueue = xQueueCreate(INTERPRETER_QUEUE_LEN,sizeof(command_t));

	//Creo la tarea donde se ejecuta el interprete de comandos que llegan de la interfaz de usuario atravez del servidor WEB
	xTaskCreate(
	      interpreter,               // Function that implements the task.
	      (const char *)"Interprete",// Text name for the task.
	      configMINIMAL_STACK_SIZE,  // Stack size in words, not bytes.
	      (void*)NULL,               // Parameter passed into the task.
	      tskIDLE_PRIORITY+1,        // Priority at which the task is created.
	      0                          // Pointer to the task created in the system
	   );
	actualPanelNumber=1;


}


//Recibe comandos desde el servidor, los interpreta y ejecuta
//Ademas genera la informacion que se va a mostrar en pantalla
void interpreter ()
{
	loadParameters (actualPanelNumber-1); 		//Cargo los parametros en los registros de la maquina de estado
	uint8_t i;
	command_t command;
	uint8_t portNum;
	uint8_t testState;
	actualPageData = pageDataA;
	actualPanel=panel0;

	//Correccion
	updateAllParameters (actualPanelNumber-1);

while (true)
{
	if(pdTRUE == xQueueReceive(commandsQueue,&command,250*portTICK_RATE_MS))
	{
		if (actualPanelNumber == command.panelNum) //Los comandos pueden ser producto de botones b (botones de la base de la interfaz de usuatio) o botones p (del panel de la interfaz)
		{
			switch (command.buttonId[0]){
						case 'b': //si se presiono un boton de la base
						{
							switch (command.buttonId[1]){
										case '0': //"<" Panel anterior
										{
											sendToAllTests (actualPanelNumber , STOP); //envio la orden de detener todas las tareas y no continuo hasta que se detuvieron
											//Cambio el panel actual al panel anterior
											if (actualPanelNumber > 1)	
												actualPanelNumber--;
											else
												actualPanelNumber = 1;
											actualPanel = panels[actualPanelNumber-1];
											updateAllParameters (actualPanelNumber-1);
											break;
										}
										case '2': //">" Panel siguiente
										{
											sendToAllTests (actualPanelNumber , STOP); //envio la orden de detener todas las tareas y no continuo hasta que se detuvieron
											//Cambio el panel actual al panel siguiente
											if (actualPanelNumber < TESTS_QTY)
												actualPanelNumber++;
											else
												actualPanelNumber = TESTS_QTY;
											actualPanel = panels[actualPanelNumber-1];
											updateAllParameters (actualPanelNumber-1);

											break;
										}
										case '4': //Boton "Parar todo"
										{
											sendToAllTests (actualPanelNumber , STOP); //envio la orden de detener todas las tareas y no continuo hasta que se detuvieron
											break;
										}
										default:
											break;
							}
							break;
						}
						case 'p': //Si se presiona un boton del panel
						{
							switch (command.buttonId[1]){
								case '1':	//en la fila uno estan los botones de STAR/STOP
								{
									portNum = command.buttonId[2]-'0';
									testState = getTestsState (portNum);
									if((testState == INIT)||(testState == STOP))
										setTestOrder (portNum, actualPanelNumber, START);
									else
										setTestOrder (portNum, actualPanelNumber, STOP);
									break;
								}
								case '7':	//en la fina 7 estan los botones de guardar
								{
									sendToAllTests (actualPanelNumber , STOP); //envio la orden de detener todas las tareas y no continuo hasta que se detuvieron
									params = getParameters ((uint32_t) actualPanelNumber-1,command.buttonId[2]-'0'); //Pido los parametros del panel actual para el puerto correspondiente al boton
									//Actualizo los parametros en RAM y luego guardo en EEPROM
									for (i=0;i<4;i++)
									{

										params[i]= command.parameters[i];

									}
									saveParameters ((uint32_t) actualPanelNumber-1); //Guardo los nuevos parametros en EEPROM
									break;
								}
								default:
									break;
							}
							break;
						}
						default:
							break;
						}
		}
	}
	refreshPageData();
}
}

//Funcion para enviar un comando al interpreter mediante una cola
void sendCommand(command_t command)
{
	xQueueSend(commandsQueue,&command,0);

}


//Funcion para actualizar los datos del panel actual 
//en los strings que luego el servidor usa para responder

void refreshPageData(){
	char*pageData;
	
	//Se usan dos strings en forma alternada de modo que se escribe en uno
	//mientras el servidor utiliza el otro
	//Dado que la tarea del servidor tiene prioridad mayor prioridad que el interpreter
	//nunca se va a cambiar el sting mientras se esta leyendo.
	if (actualPageData == pageDataA)
	{
		pageData = pageDataB;
	}
	else
		{
		pageData = pageDataA;
		}
	uint8_t i,j;
	uint8_t aux;
	uint8_t * auxPointer;
	char auxStrig[60];
	//Armo un string con formato JSON de la siguiente forma
	// {"panel":Nº de panel, "data":[,,,,]}
	stdioSprintf(pageData, "{\"panel\":%d,\"data\":[",actualPanelNumber);
	for (j=0;j<8;j++)
	{
		for (i=0;i<PORTS_NUMBER;i++)
		{
			switch (j){
				case 0:{
					stdioSprintf(auxStrig,"%d,",FSMRegisters[i].state);
					break;
				}
				case 1:
				{
					if ((FSMRegisters[i].state==STOP)||(FSMRegisters[i].state==INIT))
						aux = MARCHA;
					else
						aux = PARADA;

					stdioSprintf(auxStrig,"%d,",aux);
				break;
				}
				case 2:
				{
					stdioSprintf(auxStrig,"%d,",FSMRegisters[i].pasa);
					break;
				}
				case 3:
				{
					stdioSprintf(auxStrig,"%d,",FSMRegisters[i].param[0]);
					break;
				}
				case 4:
				{
					stdioSprintf(auxStrig,"%d,",FSMRegisters[i].param[1]);
					break;
				}
				case 5:
				{
					stdioSprintf(auxStrig,"%d,",FSMRegisters[i].param[2]);
					break;
				}
				case 6:
				{
					stdioSprintf(auxStrig,"%d,",FSMRegisters[i].param[3]);
					break;
				}
				case 7:
				{
					aux = GUARDAR;
					stdioSprintf(auxStrig,"%d,",aux);
				break;
				}
			}
			strcat (pageData,auxStrig);
		}
	}
	pageData[strlen(pageData)-1]=0; //borro la ultima coma
	strcat (pageData,"]}");

	actualPageData = pageData; //Unicamente cambio el puntero a los datos que se van a mandar cuando ya esta completa la informacion

}
