Gonzalogontad/ProyectoFinalCESEGG/Soft/modPrincipalCIAA/inc/terminal.h

/*
 * terminal.h
 *
 *  Created on: 8 sep. 2020
 *      Author: root
 */

#ifndef TERMINAL_H_
#define TERMINAL_H_

//void terminal( void* taskParmPtr );
void terminalInit();
bool_t scanParameter (char *param, uint8_t length);

#endif /* TERMINAL_H_ */
