Gonzalogontad/ProyectoFinalCESEGG/Soft/modPrincipalCIAA/inc/webPage.h

/*
 * webPage.h
 *
 *  Created on: 18 jun. 2020
 *      Author: root
 */

#ifndef WEBPAGE_H_
#define WEBPAGE_H_

#include "sapi.h"

extern char HttpWebPage[];

extern char HttpBody[];

extern char panel0[];
extern char panel1[];
extern char panel2[];


extern char pageDataA[];
extern char pageDataB[];
extern char ok[];
extern char requestError[];


extern char *actualPageData;
extern char *actualPanel;
extern uint8_t actalPanelNumber;


#endif /* PROYECTOS_CESE_PROYECTOFINALGG_PROYECTOFINALCESEGG_SOFT_MODPRINCIPALCIAA_INC_WEBPAGE_H_ */
