Gonzalogontad/ProyectoFinalCESEGG/Soft/modPrincipalCIAA/inc/modPrincipalCIAA.h

/*=============================================================================
 * Author: Gonzalo Gontad <gonzalogontad@gmail.com>
 * Date: 2020/06/14
 * Version: 1.0
 *===========================================================================*/

/*=====[Avoid multiple inclusion - begin]====================================*/

#ifndef __MODPRINCIPALCIAA_H__
#define __MODPRINCIPALCIAA_H__

/*=====[Inclusions of public function dependencies]==========================*/

#include <stdint.h>
#include <stddef.h>

/*=====[C++ - begin]=========================================================*/

#ifdef __cplusplus
extern "C" {
#endif

/*=====[Definition macros of public constants]===============================*/

/*=====[Public function-like macros]=========================================*/

/*=====[Definitions of public data types]====================================*/

/*=====[Prototypes (declarations) of public functions]=======================*/

/*=====[Prototypes (declarations) of public interrupt functions]=============*/

/*=====[C++ - end]===========================================================*/

#ifdef __cplusplus
}
#endif

/*=====[Avoid multiple inclusion - end]======================================*/

#endif /* __MODPRINCIPALCIAA_H__ */
