Gonzalogontad/ProyectoFinalCESEGG/(commit log)

2020-05-21 Creo proyecto de Hardware del modulo principal
    [ModPrincipal.kicad_pcb, ModPrincipal.sch]
2020-05-21 Creo proyecto de Hardware modulo principal
    [ModPrincipal.kicad_pcb, ModPrincipal.sch]
2020-05-22 Agrego Etapa de entrada ADCs
    [AnalogInputs.sch]
2020-05-26 Agrego etapa de salida del DAC
    [AnalogInputs.sch, AnalogOut.sch, ModPrincipal.sch, UARTAislada.sch]
2020-05-27 Agrego UART aislada y salidas digitales
    [AnalogInputs.sch, AnalogOut.sch, Core.sch, IOs digitales.sch, ModPrincipal.sch, UARTAislada.sch]
2020-05-28 Agrego fuente de alimentación
    [AnalogInputs.sch, AnalogOut.sch, CPU.sch, Fuente.sch, ModPrincipal.sch, Puerto.sch, UARTAislada.sch]
2020-05-28 Asignacion inicial de footprints
    [AnalogInputs.sch, AnalogOut.sch, CPU.sch, Fuente.sch, IOs digitales.sch, ModPrincipal.sch, Puerto.sch, UARTAislada.sch]
2020-05-29 Asignación de footprint y corrección de errores de ERC en esquematico
    [AnalogInputs.sch, AnalogOut.sch, CPU.sch, Fuente.sch, IOs digitales.sch, ModPrincipal.kicad_pcb, ModPrincipal.sch, Puerto.sch]
2020-05-29 Inicio ubicacion de componentes
    [AnalogInputs.sch, AnalogOut.sch, CPU.sch, Fuente.sch, IOs digitales.sch, ModPrincipal.kicad_pcb, ModPrincipal.sch, Puerto.sch]
2020-05-30 Avance en place de componentes
    [AnalogInputs.sch, AnalogOut.sch, CPU.sch, Fuente.sch, IOs digitales.sch, ModPrincipal.kicad_pcb, ModPrincipal.sch, Puerto.sch]
2020-05-31 Avance en trazado de pista Modulo principal
    [AnalogInputs.sch, AnalogOut.sch, CPU.sch, Fuente.sch, ModPrincipal.kicad_pcb, Puerto.sch, UARTAislada.sch]
2020-06-01 Trazado completo de PCB modulo principal V1.0
    [AnalogInputs.sch, AnalogOut.sch, CPU.sch, Fuente.sch, IOs digitales.sch, ModPrincipal.kicad_pcb, ModPrincipal.sch, Mod_Temp_Driver.kicad_pcb]
2020-06-01 Inicio Modulos Adicionales
    [Mod_Temp_Driver.sch, ProbadorDriver.sch, ProbadorTemporizador.sch]
2020-06-02 Completado de esquematico en modulos adicionales
    [CargayDimmer.sch, MedicionesAnalogicas.sch, Mod_Temp_Driver.sch]
2020-06-02 Primera correccion en modulos Adicionales y cambio de etapa de salida en modulo principal
    [AnalogInputs.sch, AnalogOut.sch, CPU.sch, CargayDimmer.sch, Fuente.sch, IOs digitales.sch, MedicionesAnalogicas.sch, ModPrincipal.kicad_pcb]
2020-06-02 Asignacion de footprints Modulos adicionales
    [CargayDimmer.sch, MedicionesAnalogicas.sch, ModPrincipal.kicad_pcb, Mod_Temp_Driver.kicad_pcb, ProbadorDriver.sch, ProbadorTemporizador.sch]
2020-06-03 Inicio placement de componentes en Modulos Adicionales
    [AnalogInputs.sch, AnalogOut.sch, CPU.sch, CargayDimmer.sch, Fuente.sch, IOs digitales.sch, MedicionesAnalogicas.sch, ModPrincipal.kicad_pcb]
2020-06-03 Avance en trazado de PCB modulos Adicionales
    [Mod_Temp_Driver.kicad_pcb]
2020-06-04 Avance en trazado de pistas Modulos Adicionales
    [CargayDimmer.sch, Mod_Temp_Driver.kicad_pcb, ProbadorDriver.sch, ProbadorTemporizador.sch]
2020-06-04 Primera version de PCBs para fabricar
    [ModPrincipal-B_Cu.gbl, ModPrincipal-B_Mask.gbs, ModPrincipal-B_Paste.gbp, ModPrincipal-B_SilkS.gbo, ModPrincipal-Edge_Cuts.gm1, ModPrincipal-F_Cu.gtl, ModPrincipal-F_Mask.gts, ModPrincipal-F_Paste.gtp]
2020-06-04 Gerbers para fabricacion
2020-06-16 Etapa de transmision del driver de Puertos
    [modPrincipalCIAA.names.csv]
2020-06-18 Agrego driver de UART de ESP
    [modPrincipalCIAA.names.csv]
2020-07-04 Avance en servidor
    [modPrincipalCIAA.names.csv]
2020-07-10 Avance en tarea interpreter
    [modPrincipalCIAA.names.csv]
2020-07-16 Correccion de bug en interpreter
    [modPrincipalCIAA.names.csv]
2020-10-05 Codigo a comentar
    [modPrincipalCIAA.names.csv]
2020-10-28 Completo comentarios y agrego el firmware para el STM32.
    [Puertos (1).cfg, Puertos.cfg]
